Selective031/RazorBoard/Pictures/RazorBoard_30V.jpg

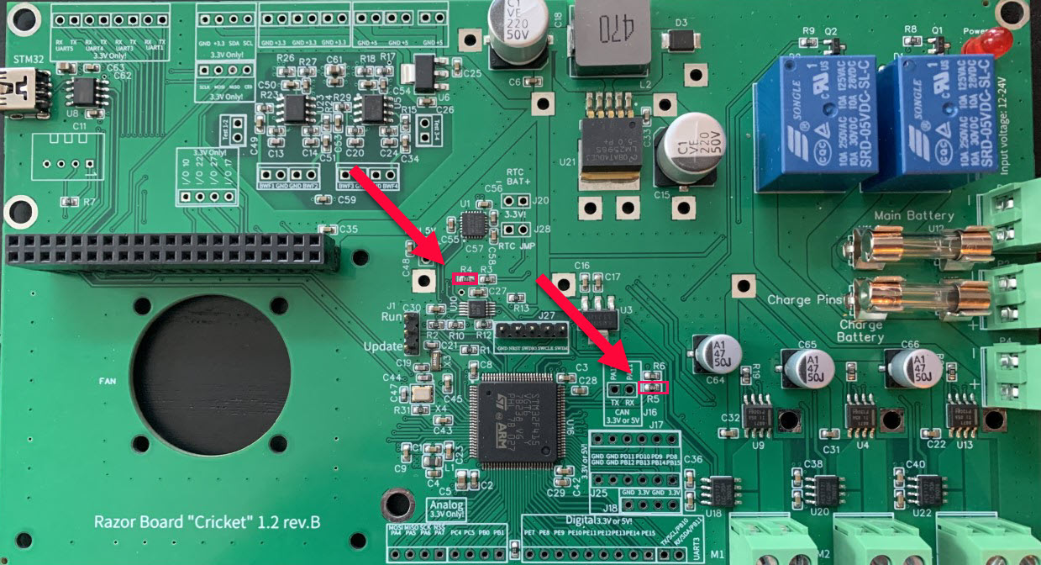
Pictures/RazorBoard_30V.jpg
