Selective031/RazorBoard/mpu_placement.JPG

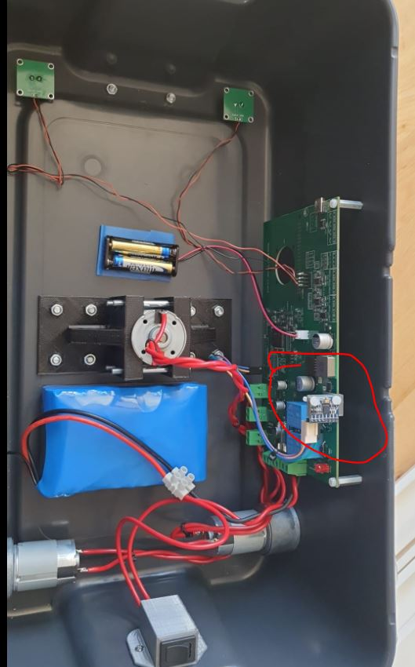
mpu_placement.JPG
