Selective031/RazorBoard/LOWPASS1.png

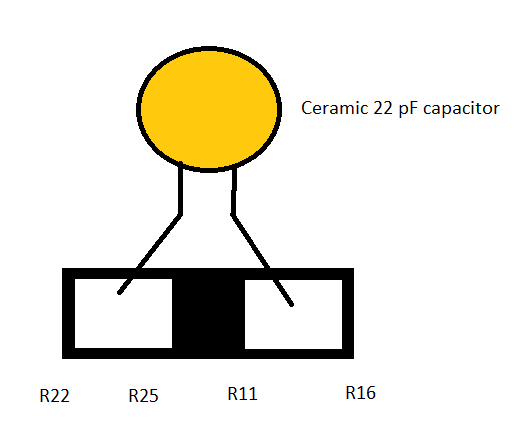
LOWPASS1.png
