Selective031/RazorBoard/Pictures/Node-RED_Nodes.JPG

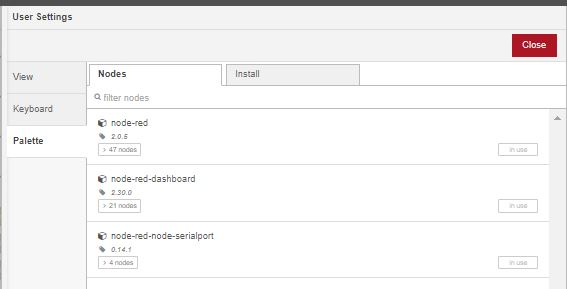
Pictures/Node-RED_Nodes.JPG
