Selective031/RazorBoard/Pictures/Node-RED_SoftwareUpdate.png

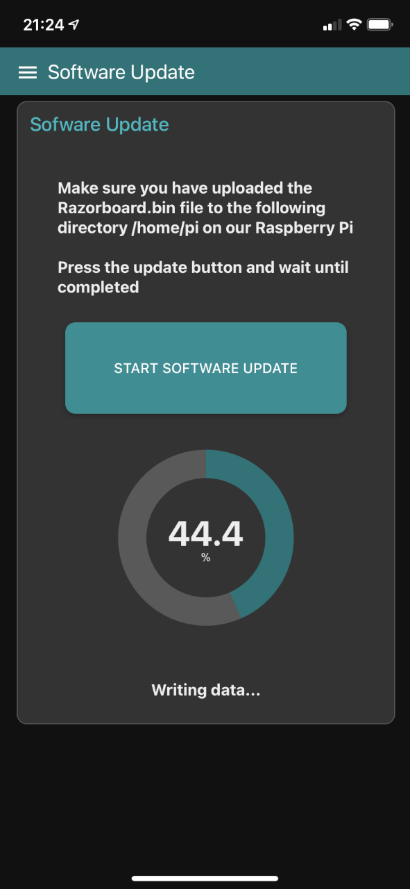
Pictures/Node-RED_SoftwareUpdate.png
