Selective031/RazorBoard/Pictures/Node-RED_Status.PNG

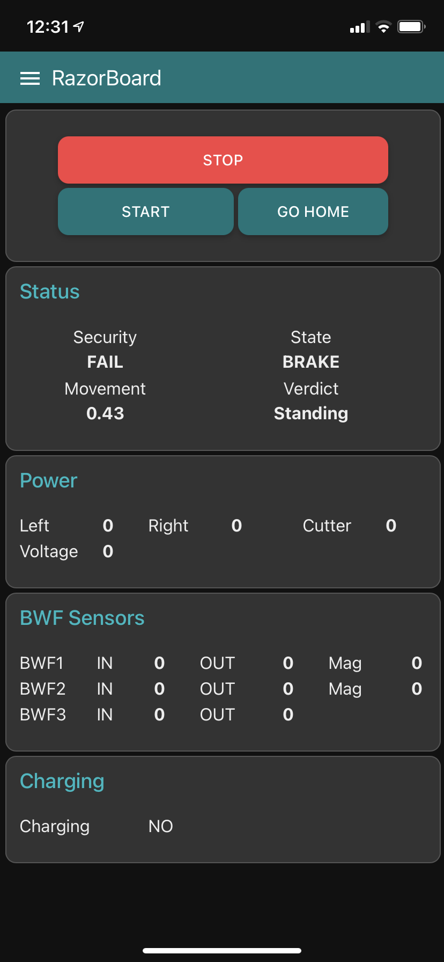
Pictures/Node-RED_Status.PNG
