Selective031/RazorBoard/Pictures/Node-RED_Terminal.JPG

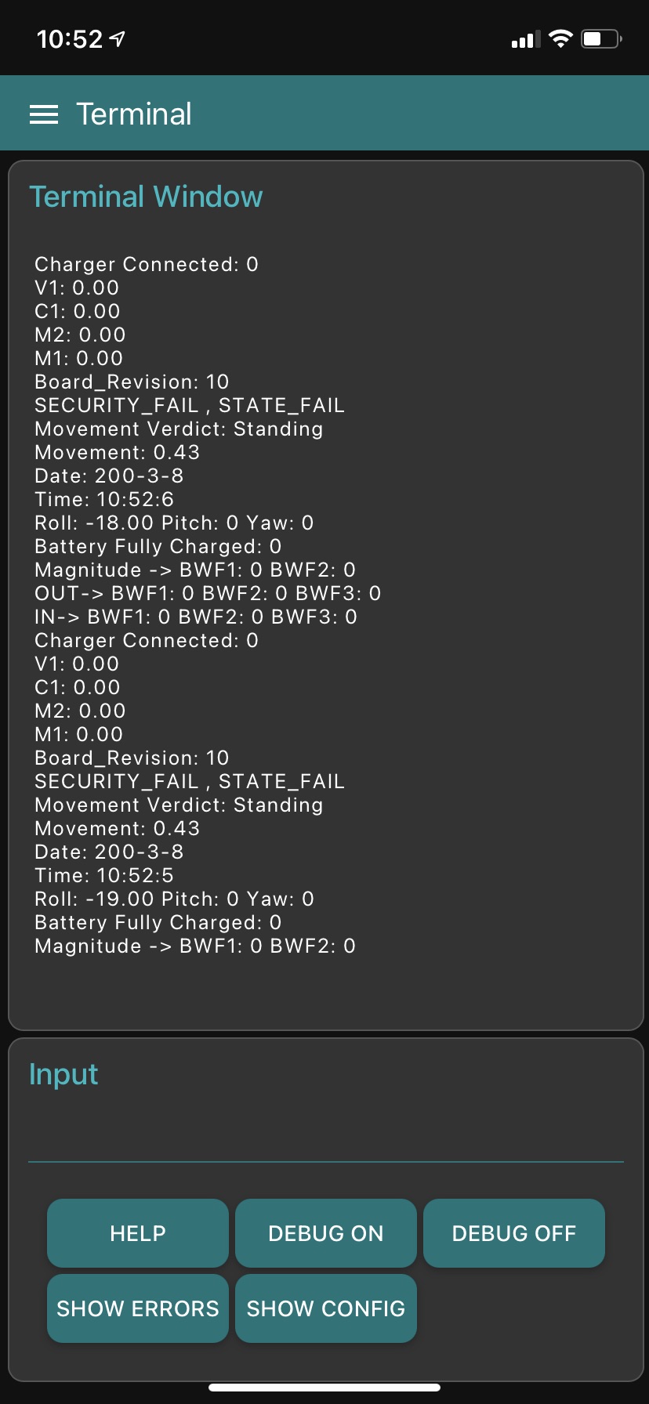
Pictures/Node-RED_Terminal.JPG
