Selective031/RazorBoard/Pictures/Remote Firmware Update.jpg

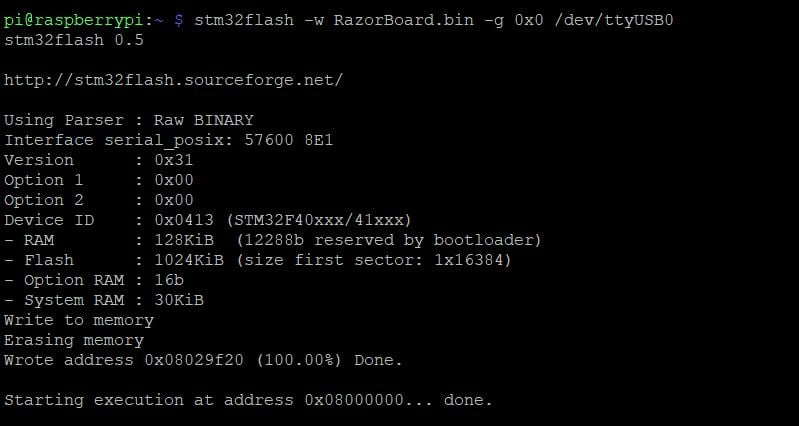
Pictures/Remote Firmware Update.jpg
