Selective031/RazorBoard/rz.png

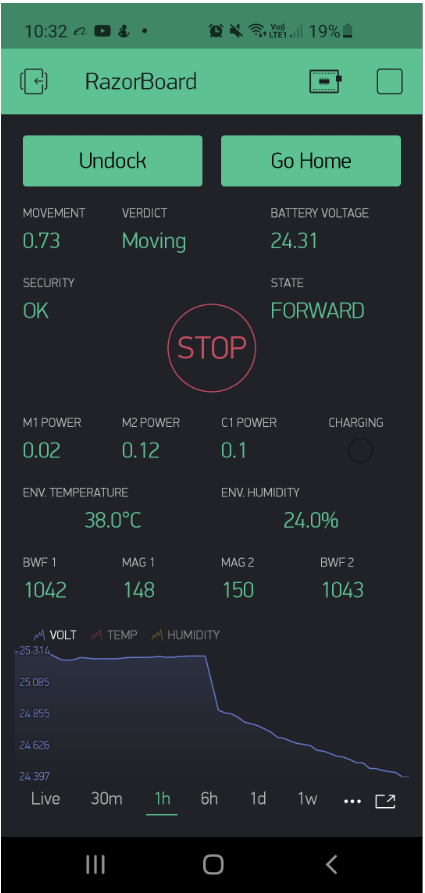
rz.png
