Selective031/RazorBoard/USB.png

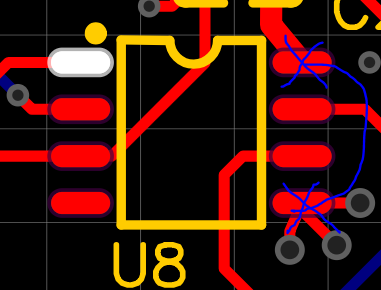
USB.png
