Selective031/RazorBoard/(threads)

Thread 1 (2021-04-14):

Add Bumper Support

Starsurfer78, 2021-04-14:
If i read the README right, they are no Bumpers yet. It would be nice if you can add it 2 Pins for it. Perhaps
Micro Switch or Hall Sensors.

Selective031, 2021-04-15:
No bumber support yet, I wrote some code a while back which I later removed because the motor spike was very good. But of course there should be bumber support.

MagnusPer, 2021-04-30:
Could not a ultrasonic sensor do the jobb!
DYP-A02YY PWM / UART DC5V Ultrasonic Ranging Sensors Ultrasonic Waterproof Distance Sensor Waterproof Probe Ultrasonic module - UART serial por

Starsurfer78, 2021-05-01:
Yes but if the Ultrasonic didn't see the Obstacle then the bumper is a safety device

Thread 3 (2021-04-16):

Stop / Halt button

MagnusPer, 2021-04-16:
A feature to stop / halt the mower by a mechanical switch without breaking the power to the board.

Selective031, 2021-04-16:
This should be a very simple enhancement, there is a "MasterSwitch" in the software, we could just connect a button via an interrupt to switch the "MasterSwitch" to off.

MagnusPer, 2021-04-27:
Another usage for this button is to restart the mower if it has gone out_of_boundary. If you today lift up the mower and walk away the cutter restarts by itself when it sense it is inside the boundary. This is mainly for security reason to not restart when you walk around with the mower!

Starsurfer78, 2021-07-29:
A Start/Stop Button is a nice Idea,
Sometimes it is necessary to send the mower home because it may not be convenient for it to mow.
So a start/stop button **and** a home button would be great.

Thread 4 (2021-04-16):

High grass detection

MagnusPer, 2021-04-16:
The current functionality is the following

`If the current is too high on the cutting disk, it will HARDBREAK and STOP, until reset by the user.`

This is most likely because of high grass and I suggest instead to turn off the cutter motor, drive away and restart the cutter again. If the current is still high after X retries then HARDBREAK and STOP and report failure HIGH GRASS

Selective031, 2021-04-16:
Agreed, the "current to high" limit is more if you hit something and the cutting disk it hitting an hard object, we don´t want to hurt anyone or risking the disk/motor/shaft to break. We could pass the value from the sensor into an array and calculate the average value for about 20-50 values or so, then detect if its hard for the disk to spin and take some action.

Selective031, 2021-05-31:
A new function is being tested.
When the high grass is detected, the mower will do:
MotorStop
MotorBackward
Wait 2 sec (to allow the cutter to speed up again)
Go forward slowly
if high grass is detected again, it will start over
if not, the mower will go forward slowly for 10 sec, then speed up to normal speed again.

Selective031, 2021-06-15:
Released

Closed 2021-06-15.

Thread 5 (2021-04-16):

Support of 30V input voltage

MagnusPer, 2021-04-16:
Many mowers today uses 7-cells Lithium batteries with a charger voltage of 29.3V. To support those battery types I suggest a hardware configuration by a jumper on the next version of PCB to support more than todays max 25.2V.

Selective031, 2021-04-16:
After our discussion I looked into it, and should not be a problem to include in a future revision. It´s only a couple of resistors to replace.

MagnusPer, 2021-04-16:
I created this issue more to inform other persons that having the same issue. However either in this issue or in the Readme section describe the needed changes.

Selective031, 2021-04-16:
This has been added to the README:

Do NOT connect a 7 cell battery! When fully charged it will output 29.4 Volt (7 * 4.2 = 29.4 Volt)
If you really need to provide a 7 cell battery, you need to replace a couple of resistors, they are in the package of SMD 0603. Without replacing them you might risk to blow up a couple of pins on the STM32 MCU.

The resistor that needs to be replaced:
-R3 30K
-R4 7.5K
-R6 30K
-R5 7.5K

With the above resistors, an input voltage of 25.2 would give us 5.0.4 volt, which we can handle.
But if using 30 Volt you will get about 6V which will burn the pins. You need to replace two of them (R3 or R4 and R5 or R6), so you don´t go above 5 Volt.
Use this link for calculating the divider. Also when you replaced them, you need to update the software to calculate the correct voltage.
https://ohmslawcalculator.com/voltage-divider-calculator
Do this at your own risk.

Thread 6 (2021-04-16):

Spinning detection

MagnusPer, 2021-04-16:
If the mower stands still but the motors is running the mower is stuck. The proposal is to use the Gyro to detect the movement where the mower should try by redirect the move direction several times in different directions till it moves again. If several retries doesn't help then HANDBREAK and STOP and report a failure MOWER STUCK

Selective031, 2021-04-16:
Good suggestion!

MagnusPer, 2021-05-03:
Clarification to my comment about using the Gyro, to solve this the accelerometer functionality in the MPU6050 is needed to be used.

Selective031, 2021-05-03:
Yes, that is understood.

Selective031, 2021-05-04:
I solution has been committed to dev branch, just need to verify and test it a bit before moving to main.

Closed 2021-05-05.

Thread 8 (2021-04-16):

Separate configuration file

MagnusPer, 2021-04-16:
Instead of rebuilding the project when change/test some configuration values a separate config file should be super!

Selective031, 2021-04-16:
This is about to be released, all functions are already done. Only thing I need to add are what settings should be presented to the user. Also, if the board doesn´t detect any settings (like powering up for the first time) it will automatically save default config.

Selective031, 2021-04-25:
The first version of this was released in 1.0.1, more to come...

MagnusPer, 2021-04-27:
I have tested the configuration introduced in 1.0.1 version. Well done!
For me OK to set this to done

Selective031, 2021-04-27:
Perfect. closing this.

Closed 2021-04-27.

Thread 9 (2021-04-21):

Turn OFF mower if voltage level is low

MagnusPer, 2021-04-21:
When the mower doesn't find the "home" the battery will be drained. Add a third voltage limit` Voltage_Limit_EMPTY` triggering to turn OFF the mower fully.

The comment in the defines is not fully correct, should be that `Voltage_Limit_LOW // When charging is needed`

```
#define Voltage_Fully_Charged  25000  // When to consider battery fully charged, if using lithium, don't fully charge, the battery will last longer.
#define Voltage_Limit_LOW 22000  // When battery is "empty"
```

Thread 12 (2021-05-03):

MotorBackward function limitations

MagnusPer, 2021-05-03:
The MotorBackward function has limitation for how long it could run in time.,

```
#define MotorMaxSpeed 2950 	// 3359 is max PWM for 25Khz at 84 MHz with APB1 Clock
#define MotorMinSpeed 2000        // Minimum speed to start with
```

in my case I want to to back harder and for longer time, but the function don't allow that due to two reasons.
`MotorBackward(MotorMinSpeed+500, MotorMaxSpeed, 3000);`

1.  if (currentSpeed >= maxSpeed) {  break;  }
2.  if (timeCount >= time_ms) {  break;  }

My expectation is that when maxSpeed has been reached the time left shall be used to be driven till it has elapsed.

```
void MotorBackward(uint16_t minSpeed, uint16_t maxSpeed, uint16_t time_ms) {

	State = BACKWARD;
	uint16_t timeCount = 0;

for (uint16_t currentSpeed = minSpeed; currentSpeed < maxSpeed; currentSpeed++) {

	  currentSpeed += 3;
	  if (currentSpeed >= maxSpeed) {
		  break;
	  }

	  TIM4->CCR1 = currentSpeed;
	  TIM4->CCR2 = 0;

	  TIM4->CCR3 = 0;
	  TIM4->CCR4 = currentSpeed;

	  HAL_Delay(1);
	  timeCount++;

	  CheckSecurity();

	  if (timeCount >= time_ms) {
		  break;
	  }
 }
```

Selective031, 2021-05-03:
Correct, this is one of the small quirks that needs to be fixed. The fix will be something like this, at the beginning of the function before the loop starts, create a timer, if the timer reaches it end during the windup, break. If there is still time left when the windup if done, loop and check security until the timer reaches the end, then break.

Selective031, 2021-05-03:
This is untested, but something like this:
```
void MotorBackward(uint16_t minSpeed, uint16_t maxSpeed, uint16_t time_ms) {

	uint32_t motor_timer;
	State = BACKWARD;
//	uint16_t timeCount = 0;

	motor_timer = HAL_GetTick();

for (uint16_t currentSpeed = minSpeed; currentSpeed < maxSpeed; currentSpeed++) {

	  currentSpeed += 3;
	  if (currentSpeed >= maxSpeed) {
		  break;
	  }

	  TIM4->CCR1 = currentSpeed;
	  TIM4->CCR2 = 0;

	  TIM4->CCR3 = 0;
	  TIM4->CCR4 = currentSpeed;

	  HAL_Delay(1);
//	  timeCount++;

//	  CheckSecurity();

	  if (HAL_GetTick() - motor_timer >= time_ms || CheckSecurity() != SECURITY_OK) {
		  break;
	  }
 }
while (HAL_GetTick() - motor_timer < time_ms) {
	if (CheckSecurity() != SECURITY_OK) break;
}
	MotorStop();
}
```

Selective031, 2021-05-03:
The fix should also be included in MotorLeft and MotorRight as well.

MagnusPer, 2021-05-03:
Yes - you are correct in also update in the other functions (MotorLeft/Right) as well

One other idea to make the function even more configurable is also to include step-up `current_speed +=3` as a argument, but that may be to much, don't really know my self if that is needed or not?

Selective031, 2021-05-03:
The step-up count is mainly because of different motors, RPM and power.. you want it to windup slowly and not too fast, so its a balance, but it could be moved to settings,

Selective031, 2021-05-04:
A fix has been committed to dev branch, which will fix this.

Closed 2021-05-05.

Thread 13 (2021-05-05):

Store of failures in SRAM

MagnusPer, 2021-05-05:
To ease the fault tracing to understanding why the mower stopped/tripped etc. The ~20 latest reported failures should be stored to SRAM. The data to store should include at least the type of failure and when it happened, preferable also the value of the data that triggered the failure

Example
`<date><time><failure type><state><data>`

```
<2021-05-05 19:26> <OUTSIDE> <STOP>
<2021-06-10 20:10> <MOTOR M1 CURRENT> <2.3 AMP> <FORWARD>
```

The list of failures should be readable via a command using the COM port

Selective031, 2021-05-31:
This is nearly complete, Razorboard now has 20 lines with 50 characters (1000 bytes) each of messages stored in SRAM, which is retained during power cycles.
Commands:
"show errors"  - will simply show a list of messages, the newest is at the bottom (scroll style)
"clear errors" - will erase the whole list
"add error" - will add a test error message to the list

Selective031, 2021-06-15:
Released

Closed 2021-06-15.

Thread 18 (2021-05-28):

Limit current consumption settings for the motors to not exceed HW limitation

MagnusPer, 2021-05-28:
The HW itself is protected but there is no way software vise to take actions if the settings is above the tolerance of the hardware. The software configuration parameter should then have a max below the HW tolerance.

Selective031, 2021-05-28:
What should the limit do? and should the limit be applied to the resistor limit or the peak limit of hardware?

MagnusPer, 2021-05-28:
You have correct, I was more in to protect persons not having the knowledge about the hardware limitation. I have instead complemented the settings description with this information

https://github.com/Selective031/RazorBoard/wiki/01.--Settings

Closed 2021-05-28.

Thread 27 (2021-07-01):

Some commands are missing in the help menu

MagnusPer, 2021-07-01:
Check the available commands and update help menu. Example are SHOW ERRORS and CLEAR ERRORS

MagnusPer, 2021-07-05:
Remove ADC level since this not is used anymore

Selective031, 2021-07-05:
The two missing commands are now added in the latest commit.
Lets keep ADC level for now, maybe we can move it to some advanced menu.
One though is to separate the different commands into sub-menus, like motors, bwf, battery etc... to make it even easier to find correct commands.

Closed 2021-07-05.

Thread 34 (2021-08-30):

Disable BLDC motors on upgrade command

MagnusPer, 2021-08-30:
When separate BLDC motor PCB (Raptor) is introduced we need to insure the motors are disabled before entering boot in RazorBoard when a Upgrade command is received.
