Selective031/RazorBoard/RazorBoard/Core/Src/main.c

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
/* Includes ------------------------------------------------------------------*/
#include "main.h"

/* USER CODE BEGIN Includes */

#define ARM_MATH_CM4

#include "stdio.h"
#include "string.h"
#include "math.h"
#include <stdlib.h>
#include <time.h>
#include <arm_math.h>
#include <fir_filter.h>
#include <signature.h>
#include <ctype.h>
#include <help.h>
#include <sram.h>
#include <mpu6050.h>
#include <adc.h>
#include <inttypes.h>
#include <stdbool.h>


/* USER CODE END Includes */

/* USER CODE BEGIN PD */

#define I2C1_SCL_Pin GPIO_PIN_6
#define I2C1_SCL_GPIO_Port GPIOB
#define I2C1_SDA_Pin GPIO_PIN_7
#define I2C1_SDA_GPIO_Port GPIOB

IWDG_HandleTypeDef hiwdg;

#define TRUE 1
#define FALSE 0

#define STOP 0
#define FORWARD 1
#define BACKWARD 2
#define LEFT 3
#define RIGHT 4
#define AVOID_OBSTACLE 5
#define FAIL 6
#define BRAKE 7
#define HARDBRAKE 8

#define NOSIGNAL 0
#define INSIDE 1
#define OUTSIDE 2

#define SECURITY_FAIL 0
#define SECURITY_OK 1
#define SECURITY_NOSIGNAL 2
#define SECURITY_LEFT 3
#define SECURITY_RIGHT 4
#define SECURITY_BUMPER 5
#define SECURITY_IMU_FAIL 6
#define SECURITY_OUTSIDE 7
#define SECURITY_MOVEMENT 8
#define SECURITY_BACKWARD_OUTSIDE 9

#define INITIAL_MAX_THRESHOLD 10000

#define PI_BFR_SIZE 64                // Buffer size for RPi
#define CONSOLE_BFR_SIZE 64            // Buffer size for Serial Console

#define MOTOR_LEFT_FORWARD TIM4->CCR2
#define MOTOR_LEFT_BACKWARD TIM4->CCR1
#define MOTOR_RIGHT_FORWARD TIM4->CCR3
#define MOTOR_RIGHT_BACKWARD TIM4->CCR4

double Tick1 = 0;
double Tick2 = 0;
double error = 0;
double lastError = 0;
double cumError = 0;
double elapsedTime = 0;
double rateError = 0;
double previousTime = 0;

uint8_t perimeterTracking = 0;
uint8_t perimeterTrackingActive = 0;

uint8_t Initial_Start = 0;
uint16_t Start_Threshold = 0;

int bwf1_inside = 0;                // Some stats, how many messages we can detect per second
int bwf2_inside = 0;
int bwf3_inside = 0;
int bwf1_outside = 0;
int bwf2_outside = 0;
int bwf3_outside = 0;

uint32_t Boundary_Timer;            // Keep track of time between signals.

float M1_amp = 0.0f;                // Values for AMP per motor
float M2_amp = 0.0f;                // Values for AMP per motor
float C1_amp = 0.0f;                // Values for AMP per motor
float M1_error = 0.0f;              // Auto calibration value stored here.
float M2_error = 0.0f;              // Auto calibration value stored here.
float C1_error = 0.0f;              // Auto calibration value stored here.
float Voltage = 0;

uint8_t BWF1_Status = 0;
uint8_t BWF2_Status = 0;
uint8_t BWF3_Status = 0;
uint8_t State = STOP;
uint8_t cutterStatus = 0;

uint32_t ADC_timer = 0;
uint32_t IMU_timer = 0;
uint32_t OUTSIDE_timer = 0;

uint8_t Docked = 0;
uint8_t Docked_Locked = 0;
uint8_t MasterSwitch = 1;            // This is the "masterswitch", by default this is turned on.

uint8_t PIBuffer[PI_BFR_SIZE];
uint8_t ConsoleBuffer[CONSOLE_BFR_SIZE];
uint8_t UART1_ready = 0;
uint8_t UART2_ready = 0;
uint8_t Security = 0;

uint8_t Battery_Ready = 0;            // Battery fully charged?

uint8_t M1_idx = 0;
uint8_t M2_idx = 0;
uint8_t C1_idx = 0;
float M1_force[20];                    // Array of power consumption of Motor M1, used for detecting if we bump into something
float M2_force[20];                    // Array of power consumption of Motor M2, used for detecting if we bump into something
float C1_force[20];
float V1_array[60];
uint8_t V1_index = 0;
float M1_F = 0;
float M2_F = 0;
float C1_F = 0;
uint8_t Force_Active = 0;            // When the mower has gained enough movement, Force_Active will turn on.

float32_t BWF1[ADC_SAMPLE_LEN / 2];
float32_t BWF2[ADC_SAMPLE_LEN / 2];
float32_t BWF3[ADC_SAMPLE_LEN / 2];
arm_fir_instance_f32 S;
uint8_t Signature_Record = FALSE;

uint16_t magBWF1, magBWF2, magBWF3;

uint32_t MotorSpeedUpdateFreq_timer = 0;        // Timer for MotorSpeed Update
uint8_t MotorSpeedUpdateFreq = 100;                // Freq to update motor speed, in milliseconds

uint8_t ChargerConnect = 0;                        // Are we connected to the charger?
uint8_t DEBUG_RAZORBOARD = 0;                    // Used by "debug on/debug off"
uint8_t mag_near_bwf = 0;

uint32_t mag_timer = 0;
uint32_t move_timer = 0;
uint32_t highgrass_timer = 0;
uint32_t tracking_timeout_timer = 0;
uint32_t GoHome_timer_IN = 0;
uint32_t GoHome_timer_OUT = 0;
uint32_t Charger_start_Timer = 0;                // start of charging time
uint16_t Charger_elapsed_Timer = 0;                // how long charge time
uint8_t highgrass_slowdown = 0;

uint8_t bumper_count = 0;
uint8_t move_count = 0;
uint8_t board_revision = 12;

sram_settings settings;
sram_error errors;
mpu6050 mpu;


/* USER CODE END PD */

ADC_HandleTypeDef hadc1;
ADC_HandleTypeDef hadc2;
DMA_HandleTypeDef hdma_adc1;
DMA_HandleTypeDef hdma_adc2;

I2C_HandleTypeDef hi2c1;
I2C_HandleTypeDef hi2c2;

IWDG_HandleTypeDef hiwdg;

RNG_HandleTypeDef hrng;

RTC_HandleTypeDef hrtc;

TIM_HandleTypeDef htim2;
TIM_HandleTypeDef htim3;
TIM_HandleTypeDef htim4;
TIM_HandleTypeDef htim5;

UART_HandleTypeDef huart1;
UART_HandleTypeDef huart2;
DMA_HandleTypeDef hdma_usart1_rx;
DMA_HandleTypeDef hdma_usart2_rx;

/* USER CODE BEGIN PV */

I2C_HandleTypeDef *razor_hi2c;

/* USER CODE END PV */

void SystemClock_Config(void);
static void MX_GPIO_Init(void);
static void MX_DMA_Init(void);
static void MX_ADC1_Init(void);
static void MX_IWDG_Init(void);
static void MX_RNG_Init(void);
static void MX_USART1_UART_Init(void);
static void MX_USART2_UART_Init(void);
static void MX_TIM3_Init(void);
static void MX_TIM4_Init(void);
static void MX_RTC_Init(void);
static void MX_TIM2_Init(void);
static void MX_TIM5_Init(void);
static void MX_I2C1_Init(void);
static void MX_ADC2_Init(void);
static void MX_I2C2_Init(void);
/* USER CODE BEGIN PFP */

static void MotorStop(void);
static void MotorBrake(void);
static void MotorHardBrake(void);
static void MotorForward(uint16_t minSpeed, uint16_t maxSpeed);
static void MotorBackward(uint16_t minSpeed, uint16_t maxSpeed, uint32_t time_ms);
static void MotorBackwardImpl(uint16_t minSpeed, uint16_t maxSpeed, uint32_t time_ms, bool forced);
static void MotorLeft(uint16_t minSpeed, uint16_t maxSpeed, uint32_t time_ms);
static void MotorRight(uint16_t minSpeed, uint16_t maxSpeed, uint32_t time_ms);
static void CheckState(void);
static uint8_t CheckSecurity(void);
static void CheckBWF(void);
static void CheckBWF_Rear(void);
static void cutterON(void);
static void cutterOFF(void);
static void cutterHardBreak(void);
static void parseCommand_RPI(void);
static void parseCommand_Console(void);
static void perimeterTracker(void);
static void ChargerConnected(void);
void HAL_UART_RxCpltCallback(UART_HandleTypeDef *huart);
void HAL_UART_TxCpltCallback(UART_HandleTypeDef *huart);
static void delay_us(uint16_t us);
static void ADC_Send(uint8_t channel);
static int ADC_Receive();
static void CollectADC(void);
static void SendInfo(void);
static void CheckMotorCurrent(int RAW);
static void UpdateMotorSpeed();
static void unDock(void);
static uint32_t rnd(uint32_t maxValue);
static void InitFIR(void);
static void FIR_LEFT(void);
static void FIR_RIGHT(void);
static void FIR_REAR(void);
static void WatchdogRefresh(void);
static void WatchdogInit(void);
static void (*SysMemBootJump)(void);
static void BootLoaderInit(unsigned long BootLoaderStatus);
static void setTime(uint8_t hour, uint8_t minute, uint8_t second);
static void setDate(uint8_t year, uint8_t month, uint8_t day, uint8_t weekday);
static void TimeToGoHome(void);
static void CalcMagnitude(uint8_t Sensor);
static void delay(uint32_t time_ms);
static void getIMUOrientation(void);
static void i2c_scanner(void);
static void Serial_DATA(char *msg);
static void I2C_ClearBusyFlagErratum(I2C_HandleTypeDef* handle, uint32_t timeout);
static bool wait_for_gpio_state_timeout(GPIO_TypeDef *port, uint16_t pin, GPIO_PinState state, uint32_t timeout);

/* USER CODE END PFP */

/* USER CODE BEGIN 0 */

bool wait_for_gpio_state_timeout(GPIO_TypeDef *port, uint16_t pin, GPIO_PinState state, uint32_t timeout)
 {
    uint32_t Tickstart = HAL_GetTick();
    bool ret = true;
    /* Wait until flag is set */
    for(;(state != HAL_GPIO_ReadPin(port, pin)) && (true == ret);)
    {
        /* Check for the timeout */
        if (timeout != HAL_MAX_DELAY)
        {
            if ((timeout == 0U) || ((HAL_GetTick() - Tickstart) > timeout))
            {
                ret = false;
            }
            else
            {
            }
        }
        asm("nop");
    }
    return ret;
}

void I2C_ClearBusyFlagErratum(I2C_HandleTypeDef* handle, uint32_t timeout)
{
    GPIO_InitTypeDef GPIO_InitStructure;

    // 1. Clear PE bit.
    CLEAR_BIT(handle->Instance->CR1, I2C_CR1_PE);

    //  2. Configure the SCL and SDA I/Os as General Purpose Output Open-Drain, High level (Write 1 to GPIOx_ODR).
    HAL_I2C_DeInit(handle);

    GPIO_InitStructure.Mode = GPIO_MODE_OUTPUT_OD;
    GPIO_InitStructure.Pull = GPIO_NOPULL;

    GPIO_InitStructure.Pin = I2C1_SCL_Pin;
    HAL_GPIO_Init(GPIOB, &GPIO_InitStructure);

    GPIO_InitStructure.Pin = I2C1_SDA_Pin;
    HAL_GPIO_Init(I2C1_SDA_GPIO_Port, &GPIO_InitStructure);

    // 3. Check SCL and SDA High level in GPIOx_IDR.
    HAL_GPIO_WritePin(I2C1_SDA_GPIO_Port, I2C1_SDA_Pin, GPIO_PIN_SET);
    HAL_GPIO_WritePin(I2C1_SCL_GPIO_Port, I2C1_SCL_Pin, GPIO_PIN_SET);

    wait_for_gpio_state_timeout(I2C1_SCL_GPIO_Port, I2C1_SCL_Pin, GPIO_PIN_SET, timeout);
    wait_for_gpio_state_timeout(I2C1_SDA_GPIO_Port, I2C1_SDA_Pin, GPIO_PIN_SET, timeout);

    // 4. Configure the SDA I/O as General Purpose Output Open-Drain, Low level (Write 0 to GPIOx_ODR).
    HAL_GPIO_WritePin(I2C1_SDA_GPIO_Port, I2C1_SDA_Pin, GPIO_PIN_RESET);

    // 5. Check SDA Low level in GPIOx_IDR.
    wait_for_gpio_state_timeout(I2C1_SDA_GPIO_Port, I2C1_SDA_Pin, GPIO_PIN_RESET, timeout);

    // 6. Configure the SCL I/O as General Purpose Output Open-Drain, Low level (Write 0 to GPIOx_ODR).
    HAL_GPIO_WritePin(I2C1_SCL_GPIO_Port, I2C1_SCL_Pin, GPIO_PIN_RESET);

    // 7. Check SCL Low level in GPIOx_IDR.
    wait_for_gpio_state_timeout(I2C1_SCL_GPIO_Port, I2C1_SCL_Pin, GPIO_PIN_RESET, timeout);

    // 8. Configure the SCL I/O as General Purpose Output Open-Drain, High level (Write 1 to GPIOx_ODR).
    HAL_GPIO_WritePin(I2C1_SCL_GPIO_Port, I2C1_SCL_Pin, GPIO_PIN_SET);

    // 9. Check SCL High level in GPIOx_IDR.
    wait_for_gpio_state_timeout(I2C1_SCL_GPIO_Port, I2C1_SCL_Pin, GPIO_PIN_SET, timeout);

    // 10. Configure the SDA I/O as General Purpose Output Open-Drain , High level (Write 1 to GPIOx_ODR).
    HAL_GPIO_WritePin(I2C1_SDA_GPIO_Port, I2C1_SDA_Pin, GPIO_PIN_SET);

    // 11. Check SDA High level in GPIOx_IDR.
    wait_for_gpio_state_timeout(I2C1_SDA_GPIO_Port, I2C1_SDA_Pin, GPIO_PIN_SET, timeout);

    // 12. Configure the SCL and SDA I/Os as Alternate function Open-Drain.
    GPIO_InitStructure.Mode = GPIO_MODE_AF_OD;
    GPIO_InitStructure.Alternate = GPIO_AF4_I2C1;

    GPIO_InitStructure.Pin = I2C1_SCL_Pin;
    HAL_GPIO_Init(I2C1_SCL_GPIO_Port, &GPIO_InitStructure);

    GPIO_InitStructure.Pin = I2C1_SDA_Pin;
    HAL_GPIO_Init(I2C1_SDA_GPIO_Port, &GPIO_InitStructure);

    // 13. Set SWRST bit in I2Cx_CR1 register.
    SET_BIT(handle->Instance->CR1, I2C_CR1_SWRST);
    asm("nop");

    /* 14. Clear SWRST bit in I2Cx_CR1 register. */
    CLEAR_BIT(handle->Instance->CR1, I2C_CR1_SWRST);
    asm("nop");

    /* 15. Enable the I2C peripheral by setting the PE bit in I2Cx_CR1 register */
    SET_BIT(handle->Instance->CR1, I2C_CR1_PE);
    asm("nop");

    // Call initialization function.
    HAL_I2C_Init(handle);
}


void Serial_DATA(char *msg) {
    HAL_UART_Transmit(&huart1, (uint8_t *) msg, strlen(msg), 100);
}

void i2c_scanner(void) {

	//72 - ADC
	//104 - MPU6050

	if (HAL_I2C_IsDeviceReady(&hi2c1, (uint16_t)(72<<1), 10, 100) == HAL_OK &&
			HAL_I2C_IsDeviceReady(&hi2c1, (uint16_t)(104<<1), 10, 100) == HAL_OK) {
		Serial_Console("Scanner OK PCB 1.2\r\n");
		board_revision = 12;
		razor_hi2c = &hi2c1;

	} else if (HAL_I2C_IsDeviceReady(&hi2c2, (uint16_t)(104<<1), 10, 100) == HAL_OK){
		Serial_Console("Scanner OK PCB 1.0\r\n");
		board_revision = 10;
		razor_hi2c = &hi2c2;
	}
	else {
		board_revision = 12;
		razor_hi2c = &hi2c1;
	}
}

void getIMUOrientation(void) {
    for (uint8_t x = 0; x < 20; x++) {
        MPU6050_Read_Accel();
        MPU6050_Read_Gyro();
        ProcessIMUData(settings);
    }
}

void delay(uint32_t time_ms) {
    uint32_t timer;
    timer = HAL_GetTick();

    while (HAL_GetTick() - timer < time_ms) {
        CheckSecurity();
    }
}

void reInitIMU(void) {
	// If the I2C bus hangs, this will clear the deadlock and re-init the MPU and ADC

	MotorStop();
	cutterOFF();

	add_error_event("reInit IMU");

	I2C_ClearBusyFlagErratum(&hi2c1, 100);

	Init6050();
}

void CalcMagnitude(uint8_t Sensor) {
    float32_t Mag_Out[LENGTH_SAMPLES / 2];
    float32_t sum = 0;
    float32_t magValue;

    if (Sensor == 1) {
        arm_cmplx_mag_f32(BWF1, Mag_Out, LENGTH_SAMPLES / 2);
    } else if (Sensor == 2) {
        arm_cmplx_mag_f32(BWF2, Mag_Out, LENGTH_SAMPLES / 2);
    }

    for (int y = 0; y < LENGTH_SAMPLES / 2; y++) {
        sum += Mag_Out[y];
    }
    arm_sqrt_f32(sum, &magValue);

    if (Sensor == 1) {
        magBWF1 = round(magValue);
    } else if (Sensor == 2) {
        magBWF2 = round(magValue);
    }

    if ((magBWF1 >= settings.magValue || magBWF2 >= settings.magValue) && (MOTOR_LEFT_FORWARD == settings.motorMaxSpeed || MOTOR_RIGHT_FORWARD == settings.motorMaxSpeed) && Docked == 0) {
        if (mag_near_bwf == 0) {
            mag_near_bwf = 1;
            highgrass_slowdown = 0;
            sprintf(emsg, "proximity alert BWF1: %d BWF2: %d", magBWF1, magBWF2);
            add_error_event(emsg);
        }
        mag_timer = HAL_GetTick();
    } else if (magBWF1 <= settings.magMinValue && magBWF2 <= settings.magMinValue && mag_near_bwf == 1 && Docked == 0) {
        if (HAL_GetTick() - mag_timer >= 3000) {
            mag_near_bwf = 0;
            for (uint32_t x = (settings.motorMaxSpeed * settings.proximitySpeed); x < settings.motorMaxSpeed; x++) {
                MOTOR_LEFT_FORWARD = x;
                MOTOR_RIGHT_FORWARD = x;
                HAL_Delay(1);
                if (CheckSecurity() != SECURITY_OK) {
                    add_error_event("Security fail while in proximity loop");
                    break;
                }
            }
        }
        sprintf(emsg, "proximity cleared BWF1: %d BWF2: %d", magBWF1, magBWF2);
        add_error_event(emsg);
    }
}

void TimeToGoHome(void) {
    // Get Time and check if we should go home

    RTC_TimeTypeDef currTime = {0};
    RTC_DateTypeDef currDate = {0};

    HAL_RTC_GetTime(&hrtc, &currTime, RTC_FORMAT_BIN);
    HAL_RTC_GetDate(&hrtc, &currDate, RTC_FORMAT_BIN);

    if (currTime.Hours >= settings.WorkingHourEnd || Voltage <= settings.Battery_Low_Limit) {
        sprintf(emsg, "tracking enabled %d", currTime.Hours);
        add_error_event(emsg);
        perimeterTracking = 1;
    }
}

void setTime(uint8_t hour, uint8_t minute, uint8_t second) {
    RTC_TimeTypeDef sTime = {0};

    sTime.Hours = RTC_ByteToBcd2(hour);
    sTime.Minutes = RTC_ByteToBcd2(minute);
    sTime.Seconds = RTC_ByteToBcd2(second);
    sTime.DayLightSaving = RTC_DAYLIGHTSAVING_NONE;
    sTime.StoreOperation = RTC_STOREOPERATION_SET;
    HAL_RTC_SetTime(&hrtc, &sTime, RTC_FORMAT_BCD);
}

void setDate(uint8_t year, uint8_t month, uint8_t day, uint8_t weekday) {
    RTC_DateTypeDef sDate = {0};

    sDate.WeekDay = RTC_ByteToBcd2(weekday);
    sDate.Month = RTC_ByteToBcd2(month);
    sDate.Date = RTC_ByteToBcd2(day);
    sDate.Year = RTC_ByteToBcd2(year);
    HAL_RTC_SetDate(&hrtc, &sDate, RTC_FORMAT_BCD);
}

void BootLoaderInit(unsigned long BootLoaderStatus)

// Inside the debug menu you can type "upgrade", this will force the STM into the bootloader, so no need to change the jumper.
{
    SysMemBootJump = (void (*)(void)) (*((unsigned long *) 0x1fff0004));
    if (BootLoaderStatus == 1) {
        HAL_DeInit();
        SysTick->CTRL = 0;
        SysTick->LOAD = 0;
        SysTick->VAL = 0;
        __set_PRIMASK(1);
        __set_MSP(0x20001000);
        SysMemBootJump();
        while (1);
    }
}

void WatchdogInit(void) {
    /*
        Watchdog freq: 32.768 kHz
        Prescaler: 16
        Reload: 4095

        Our Watchdog:

        16 * 4095 = 64
        64 / 32 = 2 seconds
        if the watchdog is not fed within 2 seconds, the Razorboard will simply reboot.
    */

    hiwdg.Instance = IWDG;
    hiwdg.Init.Prescaler = IWDG_PRESCALER_16;
    hiwdg.Init.Reload = 4095;
    HAL_IWDG_Init(&hiwdg);
}

void WatchdogRefresh(void) {
    // refresh the watchdog

    HAL_IWDG_Refresh(&hiwdg);
}

void InitFIR(void) {
    // Initiate the FIR functions

    uint32_t blocksize = BLOCK_SIZE;
    arm_fir_init_f32(&S, NUM_TAPS, (float32_t *) &firCoeffs32[0], &firStateF32[0], blocksize);
}

void FIR_LEFT(void) {
    uint32_t i;
    uint32_t blockSize = BLOCK_SIZE;
    uint32_t numBlocks = LENGTH_SAMPLES / BLOCK_SIZE;
    float32_t *inputF32, *outputF32;
    inputF32 = &BWF1[0];
    outputF32 = &Output[0];
    for (i = 0; i < numBlocks; i++) {
        arm_fir_f32(&S, inputF32 + (i * blockSize), outputF32 + (i * blockSize), blockSize);
    }
    for (int x = 0; x < 256; x++) {
        BWF1[x] = (float) outputF32[x];
    }
}

void FIR_RIGHT(void) {
    uint32_t i;
    uint32_t blockSize = BLOCK_SIZE;
    uint32_t numBlocks = LENGTH_SAMPLES / BLOCK_SIZE;
    float32_t *inputF32, *outputF32;
    inputF32 = &BWF2[0];
    outputF32 = &Output[0];
    for (i = 0; i < numBlocks; i++) {
        arm_fir_f32(&S, inputF32 + (i * blockSize), outputF32 + (i * blockSize), blockSize);
    }
    for (int x = 0; x < 256; x++) {
        BWF2[x] = (float) outputF32[x];
    }
}

void FIR_REAR(void) {
    uint32_t i;
    uint32_t blockSize = BLOCK_SIZE;
    uint32_t numBlocks = LENGTH_SAMPLES / BLOCK_SIZE;
    float32_t *inputF32, *outputF32;
    inputF32 = &BWF3[0];
    outputF32 = &Output[0];
    for (i = 0; i < numBlocks; i++) {
        arm_fir_f32(&S, inputF32 + (i * blockSize), outputF32 + (i * blockSize), blockSize);
    }
    for (int x = 0; x < 256; x++) {
        BWF3[x] = (float) outputF32[x];
    }
}

uint32_t rnd(uint32_t maxValue) {
    // Our random number generator

    uint32_t rndnum;
    rndnum = HAL_RNG_GetRandomNumber(&hrng) % maxValue;
    return rndnum + 1;
}

void CheckMotorCurrent(int RAW) {
    // Check if any motor is experiencing a spike in power, then we probably hit something.

    float M1, M2;
    if (M1_idx == 10 || M2_idx == 10 || C1_idx == 10) {
        Force_Active = 1;
    }

    if (Channel == M1_addr) {
        M1_Value = RAW;
        M1 = fabsf(((M1_Value * 0.1875) - 2500) / 100);
        if (Initial_Start == 0) {
            M1_error = M1;
        }
        M1_amp = fabsf(M1 - M1_error);
        M1_force[M1_idx] = M1_amp;
        M1_idx++;
        if (M1_idx == 20) {
            M1_idx = 0;
        }
        float ForceM1 = 0;
        for (int x = 0; x < 20; x++) {
            ForceM1 += M1_force[x];
        }
        M1_F = ForceM1 / 20;
        if (M1_F < settings.Motor_Min_Limit) {
            M1_F = settings.Motor_Min_Limit;
        }
        if ((M1_amp >= settings.Motor_Max_Limit || M1_amp >= M1_F * settings.Motor_Limit) && State == (FORWARD || RIGHT) && Force_Active == 1 && M1_amp < 10.0) {
            sprintf(emsg, "M1 current: %.2f", M1_amp);
            add_error_event(emsg);
            sprintf(msg, "Motor Current Limit reached for M1: %.2f", M1_amp);
            Serial_Console(msg);

            if (HAL_GPIO_ReadPin(GPIOA, GPIO_PIN_8) == GPIO_PIN_SET) {
                return;
            }
            MotorBrake();
            delay(500);
            MotorBackward(settings.motorMinSpeed, settings.motorMaxSpeed, 1500);
            delay(500);
            MotorRight(settings.motorMinSpeed, settings.motorMaxSpeed, 1000);
            Force_Active = 0;
            bumper_count++;
            M1_amp = 0;
        }
    } else if (Channel == M2_addr) {
        M2_Value = RAW;
        M2 = fabsf(((M2_Value * 0.1875) - 2500) / 100);
        if (Initial_Start == 0) {
            M2_error = M2;
        }
        M2_amp = fabsf(M2 - M2_error);
        M2_force[M2_idx] = M2_amp;
        M2_idx++;
        if (M2_idx == 20) {
            M2_idx = 0;
        }
        float ForceM2 = 0;
        for (int x = 0; x < 20; x++) {
            ForceM2 += M2_force[x];
        }
        M2_F = ForceM2 / 20;
        if (M2_F < settings.Motor_Min_Limit) {
            M2_F = settings.Motor_Min_Limit;
        }
        if ((M2_amp >= settings.Motor_Max_Limit || M2_amp >= M2_F * settings.Motor_Limit) && State == (FORWARD || LEFT) && Force_Active == 1 && M2_amp < 10.0) {
            sprintf(emsg, "M2 current: %.2f", M2_amp);
            add_error_event(emsg);
            sprintf(msg, "Motor Current Limit reached for M2: %.2f", M2_amp);
            Serial_Console(msg);

            if (HAL_GPIO_ReadPin(GPIOA, GPIO_PIN_8) == GPIO_PIN_SET) {
                return;
            }
            MotorBrake();
            delay(500);
            MotorBackward(settings.motorMinSpeed, settings.motorMaxSpeed, 1500);
            delay(500);
            MotorLeft(settings.motorMinSpeed, settings.motorMaxSpeed, 1000);
            Force_Active = 0;
            bumper_count++;
            M2_amp = 0;
        }
    }
}

void SendInfo() {
    if (DEBUG_RAZORBOARD == 0) {
        bwf1_inside = 0;
        bwf1_outside = 0;
        bwf2_inside = 0;
        bwf2_outside = 0;
        bwf3_inside = 0;
        bwf3_outside = 0;
        return;
    }

    // Send info to the Console & Raspberry PI - Update frequency is ~1 Hz
    RTC_TimeTypeDef currTime = {0};
    RTC_DateTypeDef currDate = {0};

    HAL_RTC_GetTime(&hrtc, &currTime, RTC_FORMAT_BIN);
    HAL_RTC_GetDate(&hrtc, &currDate, RTC_FORMAT_BIN);

    sprintf(msg, "M1: %.2f\r\n", M1_amp);
    Serial_DATA(msg);
    sprintf(msg, "M2: %.2f\r\n", M2_amp);
    Serial_DATA(msg);
    sprintf(msg, "C1: %.2f\r\n", C1_amp);
    Serial_DATA(msg);
    sprintf(msg, "V1: %.2f\r\n", Voltage);
    Serial_DATA(msg);
    sprintf(msg, "Charger Connected: %d\r\n", ChargerConnect);
    Serial_DATA(msg);
    if (ChargerConnect == 1) {
        sprintf(msg, "Charger elapsed time (min): %d\r\n", Charger_elapsed_Timer);
        Serial_DATA(msg);
    }
    sprintf(msg, "IN-> BWF1: %d BWF2: %d BWF3: %d\r\nOUT-> BWF1: %d BWF2: %d BWF3: %d\r\n", bwf1_inside, bwf2_inside,
            bwf3_inside, bwf1_outside, bwf2_outside, bwf3_outside);
    Serial_DATA(msg);
    sprintf(msg, "Magnitude -> BWF1: %d BWF2: %d\r\n", magBWF1, magBWF2);
    Serial_DATA(msg);
    sprintf(msg, "Battery Fully Charged: %d\r\n", Battery_Ready);
    Serial_DATA(msg);
    sprintf(msg, "Roll: %.2f Pitch: %2.f Yaw: %2.f\r\n", mpu.roll, mpu.pitch, mpu.yaw);
    Serial_DATA(msg);
    sprintf(msg, "Time: %d:%d:%d\r\n", currTime.Hours, currTime.Minutes, currTime.Seconds);
    Serial_DATA(msg);
    sprintf(msg, "Date: 20%d-%d-%d\r\n", currDate.Year, currDate.Month, currDate.Date);
    Serial_DATA(msg);
    sprintf(msg, "Movement: %.2f\r\n", mpu.movement);
    Serial_DATA(msg);
    sprintf(msg, "Perimeter tracking: %d\r\n", perimeterTracking);
    Serial_DATA(msg);
    if (mpu.movement < settings.movement) {
        sprintf(msg, "Movement Verdict: Standing\r\n");
    } else {
        sprintf(msg, "Movement Verdict: Moving\r\n");
    }
    Serial_DATA(msg);
    if (Security == 0) {
        Serial_DATA("Security FAIL\r\n");
    }
    if (Security == 1) {
        Serial_DATA("Security OK\r\n");
    }
    if (Security == 2) {
        Serial_DATA("Security OUTSIDE\r\n");
    }
    if (Security == 3) {
        Serial_DATA("Security LEFT\r\n");
    }
    if (Security == 4) {
        Serial_DATA("Security RIGHT\r\n");
    }
    if (Security == 5) {
        Serial_DATA("Security BUMPER\r\n");
    }
    if (Security == 6) {
        Serial_DATA("Security IMU_FAIL\r\n");
    }
    if (Security == 7) {
        Serial_DATA("Security OUSIDE\r\n");
    }
    if (Security == 8) {
        Serial_DATA("Security MOVEMENT\r\n");
    }
    if (Security == 9) {
        Serial_DATA("Security BACKWARD_OUTSIDE\r\n");
    }
    if (State == 0) {
        Serial_DATA("State STOP\r\n");
    }
    if (State == 1) {
        Serial_DATA("State FORWARD\r\n");
    }
    if (State == 2) {
        Serial_DATA("State BACKWARD\r\n");
    }
    if (State == 3) {
        Serial_DATA("State LEFT\r\n");
    }
    if (State == 4) {
        Serial_DATA("State RIGHT\r\n");
    }
    if (State == 5) {
        Serial_DATA("State AVOID_OBSTACLE\r\n");
    }
    if (State == 6) {
        Serial_DATA("State FAIL\r\n");
    }
    if (State == 7) {
        Serial_DATA("State BRAKE\r\n");
    }
    if (State == 8) {
        Serial_DATA("State HARDBRAKE\r\n");
    }
    sprintf(msg, "Docking Station Locked: %u\r\n", Docked_Locked);
    Serial_Console(msg);
    sprintf(msg, "Board_Revision: %d\r\n", board_revision);
    Serial_DATA(msg);

/*
    char Data[128];

    sprintf(Data, "Battery Voltage,%.2f\r\n"
                  "M1 Current,%.2f\r\n"
                  "M2 Current,%.2f\r\n"
                  "C1 Current,%.2f\r\n"
                  "Security,%d\r\n"
                  "Mower State,%d\r\n", Voltage, M1_amp, M2_amp, C1_amp, Security, State);

*/
    bwf1_inside = 0;
    bwf1_outside = 0;
    bwf2_inside = 0;
    bwf2_outside = 0;
    bwf3_inside = 0;
    bwf3_outside = 0;

//    HAL_UART_Transmit(&huart2, (uint8_t *) &Data, strlen(Data), 100);

}

void CollectADC() {
    // Collect IC2 data from the external ADC, in a non-blocking way.

    if (Channel == M1_addr && Channel_Status == 0) {
        ADC_Send(Channel);
        Channel_Status = 1;
        ADC_timer = HAL_GetTick();
    } else if (Channel == M2_addr && Channel_Status == 0) {
        ADC_Send(Channel);
        Channel_Status = 1;
        ADC_timer = HAL_GetTick();
    } else if (Channel == C1_addr && Channel_Status == 0) {
        ADC_Send(Channel);
        Channel_Status = 1;
        ADC_timer = HAL_GetTick();
    } else if (Channel == V1_addr && Channel_Status == 0) {
        ADC_Send(Channel);
        Channel_Status = 1;
        ADC_timer = HAL_GetTick();
    }

    if ((HAL_GetTick() - ADC_timer) >= 20 && Channel_Status == 1) {
        int RAW = 0;
        RAW = ADC_Receive();

        CheckMotorCurrent(RAW);

        if (Channel == C1_addr && Docked == 0) {
            C1_Value = RAW;
            float C1;
            C1 = fabsf(((C1_Value * 0.1875) - 2500) / 100);
            if (Initial_Start == 0) {
                C1_error = C1;
            }
            C1_amp = fabsf(C1 - C1_error);

            if (C1_amp >= settings.highgrass_Limit && mag_near_bwf == 0 && C1_amp < 10.0) {
                C1_amp = 0.0;
                highgrass_slowdown = 1;
                MotorStop();
                MotorBackward(settings.motorMinSpeed, settings.motorMaxSpeed, 1500);
                delay(2500);
                MotorForward(settings.motorMinSpeed, settings.motorMaxSpeed * 0.78);
                highgrass_timer = HAL_GetTick();
            } else {
                if (HAL_GetTick() - highgrass_timer >= 5000 && highgrass_slowdown == 1) {
                    highgrass_slowdown = 0;
                    for (uint32_t x = (settings.motorMaxSpeed * 0.78); x < settings.motorMaxSpeed; x++) {
                        MOTOR_LEFT_FORWARD = x;
                        MOTOR_RIGHT_FORWARD = x;
                        delay(1);
                        if (CheckSecurity() != SECURITY_OK) {
                            add_error_event("Security fail while in high grass loop");
                            break;
                        }
                    }
                }
            }
            if (C1_amp >= settings.Cutter_Limit) {
                sprintf(emsg, "C1 current: %.2f", C1_amp);
                add_error_event(emsg);
                MasterSwitch = 0;
                return;
            }
        } else if (Channel == V1_addr) {
            V1_Value = RAW;
            V1_array[V1_index] = (V1_Value * 0.1875) * settings.voltageMultiply / 1000;
            V1_index++;
            if (V1_index >= 60) {
                V1_index = 0;
            }
            float volt_sum = 0.0;
            for (uint8_t x = 0; x < 60; x++) {
                volt_sum += V1_array[x];
            }
            Voltage = volt_sum / 60;
        }

        if (Channel == M1_addr) {
            Channel = M2_addr;
        } else if (Channel == M2_addr) {
            Channel = C1_addr;
        } else if (Channel == C1_addr) {
            Channel = V1_addr;
        } else if (Channel == V1_addr) {
            Channel = M1_addr;
        }
        Channel_Status = 0;
    }
}

void delay_us(uint16_t us) {
    __HAL_TIM_SET_COUNTER(&htim5, 0);  // set the counter value a 0
    while (__HAL_TIM_GET_COUNTER(&htim5) < us);  // wait for the counter to reach the us input in the parameter
}

void unDock(void) {
    // Simple undock sequence,  check if Battery is ready (fully charged) and if we are within working hours.

    RTC_TimeTypeDef currTime = {0};
    RTC_DateTypeDef currDate = {0};

    HAL_RTC_GetTime(&hrtc, &currTime, RTC_FORMAT_BIN);
    HAL_RTC_GetDate(&hrtc, &currDate, RTC_FORMAT_BIN);

    if (currTime.Hours >= settings.WorkingHourStart && currTime.Hours < settings.WorkingHourEnd && Battery_Ready == 1 && Docked == 1 && Docked_Locked == 0) {
        add_error_event("Switch Main Battery");
        Serial_Console("Switching to Main Battery\r\n");
        HAL_GPIO_WritePin(GPIOD, GPIO_PIN_0, GPIO_PIN_RESET);
        HAL_Delay(5000);

        MasterSwitch = 1;

        mpu.roll = 0;
        mpu.pitch = 0;
        Docked = 0;

        MotorBackwardImpl(settings.motorMinSpeed, settings.motorMaxSpeed, settings.undock_backing_seconds * 1000, true);
        MotorLeft(settings.motorMinSpeed, settings.motorMaxSpeed, 800);            // This needs to be changed if your docking is on the right side

        Initial_Start = 0;
        Start_Threshold = 0;
        Battery_Ready = 0;
        lastError = 0;
        perimeterTracking = 0;
        perimeterTrackingActive = 0;
        write_all_settings(settings);
    }
}

void ChargerConnected(void) {

	// Is the charger connected?

    if (ChargerConnect == 0) {                    // We are not charging, reset charger start timer
        Charger_start_Timer = HAL_GetTick();
        Charger_elapsed_Timer = 0;
    }

    if (ChargerConnect == 1) {                    // We are charging, calculate duration in minutes
        Charger_elapsed_Timer = (HAL_GetTick() - Charger_start_Timer) / 60000;
    }
    if (ChargerConnect == 1 || Docked == 1) {
        if (Voltage >= settings.Battery_High_Limit && Battery_Ready == 0 && Charger_elapsed_Timer >= settings.BatteryChargeTime) {
            Battery_Ready = 1;
            HAL_GPIO_WritePin(GPIOC, GPIO_PIN_10, GPIO_PIN_RESET);
            add_error_event("Charger disconnect");
            Serial_Console("Charger disconnected.\r\n");
            ChargerConnect = 0;
            HAL_Delay(5000);
            unDock();
        }
        return;
    }

    if (HAL_GPIO_ReadPin(GPIOA, GPIO_PIN_8) == GPIO_PIN_SET) {            // Read Volt sense pin
        HAL_Delay(settings.HoldChargeDetection);                          // Wait for a while so a proper connection is made
        Force_Active = 0;
        MotorBrake();
        cutterHardBreak();
        add_error_event("Charger connect");
        Serial_Console("Charger Connected\r\n");
        HAL_Delay(5000);
        HAL_GPIO_WritePin(GPIOD, GPIO_PIN_0, GPIO_PIN_SET);               // Main Power switch
        Serial_Console("Changing Main Power\r\n");
        ChargerConnect = 1;
        Docked = 1;
        HAL_Delay(2000);
        HAL_GPIO_WritePin(GPIOC, GPIO_PIN_10, GPIO_PIN_SET);              // Charger Switch
        add_error_event("Charging active");
        Serial_Console("Charging activated\r\n");

        return;
    }
}

void perimeterTracker(void) {
    CheckSecurity();

    mag_near_bwf = 0;
    highgrass_slowdown = 0;

    elapsedTime = HAL_GetTick() - previousTime;

    if (BWF2_Status == OUTSIDE) {
        Tick1 -= elapsedTime;
        Tick2 = 0;
        GoHome_timer_IN = HAL_GetTick();

        if (HAL_GetTick() - GoHome_timer_OUT >= 10000) {        // 10 seconds
            perimeterTrackingActive = 0;
            perimeterTracking = 0;
            MasterSwitch = 0;
            add_error_event("Stuck perimeterTracking BWF2 OUT - HALT");
            return;
        }
    }

    if (BWF2_Status == INSIDE) {
        Tick2 -= (elapsedTime * 4);
        Tick1 = 0;
        GoHome_timer_OUT = HAL_GetTick();

        if (HAL_GetTick() - GoHome_timer_IN >= 10000) {            // 10 seconds
            perimeterTrackingActive = 0;
            perimeterTracking = 0;
            MasterSwitch = 0;
            add_error_event("Stuck perimeterTracking BWF2 IN - HALT");
            return;
        }
    }

    error = settings.perimeterTrackerSpeed - (Tick1 + Tick2);                // determine error
    cumError += error * elapsedTime;               // compute integral
    rateError = (error - lastError) / elapsedTime;   // compute derivative

    double out = settings.kp * error + settings.ki * cumError + settings.kd * rateError;                //PID output

    lastError = error;                             //remember current error
    previousTime = HAL_GetTick();                  //remember current time

    int speedA = (settings.perimeterTrackerSpeed + round(out));
    int speedB = (settings.perimeterTrackerSpeed - round(out));

    if (speedA > settings.perimeterTrackerSpeed) {
        speedA = settings.perimeterTrackerSpeed;
    }                // limit upper and lower speed
    if (speedB > settings.perimeterTrackerSpeed)
        speedB = settings.perimeterTrackerSpeed;

    if (speedA < 1000)
        speedA = 1000;
    if (speedB < 1000)
        speedB = 1000;

    if (BWF2_Status == OUTSIDE) {
        if (BWF1_Status == OUTSIDE) {
            MOTOR_LEFT_BACKWARD = settings.perimeterTrackerSpeed * 0.90;            // if both boundary sensors are OUTSIDE, reverse M1 motor, this logic needs to be changed if docking is to the right
            MOTOR_LEFT_FORWARD = 0;
            HAL_Delay(200);
        } else if (BWF1_Status == INSIDE) {
            MOTOR_LEFT_BACKWARD = 0;
            MOTOR_LEFT_FORWARD = speedB;
        }

        MOTOR_RIGHT_FORWARD = speedA;
        MOTOR_RIGHT_BACKWARD = 0;
    }

    if (BWF2_Status == INSIDE) {
        MOTOR_LEFT_BACKWARD = 0;
        MOTOR_LEFT_FORWARD = speedA;

        MOTOR_RIGHT_FORWARD = speedB;
        MOTOR_RIGHT_BACKWARD = 0;
    }
}

void parseCommand_Console(void) {
    // Parse commands from the Console

    char Command[64] = {"\0"};

    for (uint8_t x = 0; x < sizeof(ConsoleBuffer); x++) {
        if (ConsoleBuffer[x] == 13) {
            if (ConsoleBuffer[0] == 13) {
                memcpy(Command, "DISABLE", 7);
            } else {
                memcpy(Command, ConsoleBuffer, x);
            }
            sprintf(msg, "%s\r\n", Command);
            Serial_Console(msg);
            for (uint8_t i = 0; i < CONSOLE_BFR_SIZE; i++) {
                Command[i] = toupper(Command[i]);
            }

            if (strcmp(Command, "HELLO") == 0) {
                Serial_Console("Hello fellow user! Welcome to RazorBoard!\r\n");
            }
            if (strcmp(Command, "VERSION") == 0) {
                sprintf(msg, "%s\r\n", VERSION);
                Serial_Console(msg);
            }
            if (strcmp(Command, "DEBUG ON") == 0) {
                DEBUG_RAZORBOARD = 1;
                Serial_Console("DEBUG is now ON\r\n");
            }
            if (strcmp(Command, "DEBUG OFF") == 0) {
                DEBUG_RAZORBOARD = 0;
                Serial_Console("DEBUG is now OFF\r\n");
            }
            if (strcmp(Command, "VOLTAGE") == 0) {
                sprintf(msg, "%.2f\r\n", Voltage);
                Serial_Console(msg);
            }
            if (strcmp(Command, "UPGRADE") == 0) {
                Serial_Console("Entering Bootloader...\r\n");
                HAL_Delay(500);
                BootLoaderInit(1);
            }
            if (strcmp(Command, "SHOW SIG") == 0) {
                Serial_Console("Signature will be printed in 8 seconds, please start your plotter before.\r\n");
                HAL_Delay(8000);
                for (int x = 0; x < SIGNATURE_LEN; x++) {
                    sprintf(msg, "%f\r\n", validSignature[x]);
                    Serial_Console(msg);
                }
            }
            if (strcmp(Command, "EXPORT SIG") == 0) {
                Serial_Console("Signature exported as an array\r\n");
                Serial_Console("{ ");
                for (int x = 0; x < SIGNATURE_LEN; x++) {
                    sprintf(msg, "%f,", validSignature[x]);
                    Serial_Console(msg);
                }
                Serial_Console(" };\r\n");
            }
            if (strcmp(Command, "RECORD SIG") == 0) {
                Signature_Record = TRUE;
                Serial_Console("Done!\r\n");
            }
            if (strcmp(Command, "TEST LEFT MOTOR") == 0) {
                MOTOR_LEFT_BACKWARD = 0;
                MOTOR_LEFT_FORWARD = 2000;
                HAL_Delay(3000);
                MotorStop();
                Serial_Console("Done.\r\n");
            }
            if (strcmp(Command, "TEST RIGHT MOTOR") == 0) {
                MOTOR_RIGHT_FORWARD = 2000;
                MOTOR_RIGHT_BACKWARD = 0;
                HAL_Delay(3000);
                MotorStop();
                Serial_Console("Done.\r\n");
            }
            if (strcmp(Command, "REBOOT") == 0) {
                Serial_Console("Rebooting...\r\n");
                HAL_Delay(500);
                NVIC_SystemReset();
            }
            if (strcmp(Command, "LOCK DOCKING") == 0) {
                Serial_Console("Docking LOCKED.\r\n");
                Docked_Locked = 1;
            }
            if (strcmp(Command, "UNLOCK DOCKING") == 0) {
                Serial_Console("Docking UNLOCKED.\r\n");
                Docked_Locked = 0;
            }
            if (strcmp(Command, "LOAD CONFIG") == 0) {
                settings = read_all_settings();
                Serial_Console("Config loaded.\r\n");
            }
            if (strcmp(Command, "SHOW CONFIG") == 0) {
                show_config(settings);
            }
            if (strcmp(Command, "SHOW ERRORS") == 0) {
                show_error();
            }
            if (strcmp(Command, "ADD ERROR") == 0) {
                add_error_event("This is a test error!");
            }

            if (strcmp(Command, "CLEAR ERRORS") == 0) {
                clear_errors();
            }

            if (strcmp(Command, "SAVE CONFIG") == 0) {
                write_all_settings(settings);
                settings = read_all_settings();
                Serial_Console("Settings saved.\r\n");
            }
            if (strcmp(Command, "SAVE DEFAULT CONFIG") == 0) {
                save_default_settings(board_revision);
                settings = read_all_settings();
                Serial_Console("Default settings saved.\r\n");
            }
            if (strcmp(Command, "SHOW CURRENT") == 0) {
                sprintf(msg, "M1: %.2f\r\nM2: %.2f\r\nC1: %.2f\r\n", M1_amp, M2_amp, C1_amp);
                Serial_Console(msg);
            }
            if (strcmp(Command, "STOP MOTORS") == 0) {
                MotorStop();
            }
            if (strcmp(Command, "RUN MOTORS FORWARD") == 0) {
                State = FORWARD;
                MOTOR_LEFT_BACKWARD = 0;
                MOTOR_LEFT_FORWARD = settings.motorMinSpeed;
                MOTOR_RIGHT_FORWARD = settings.motorMinSpeed;
                MOTOR_RIGHT_BACKWARD = 0;
            }
            if (strcmp(Command, "RUN MOTORS REVERSE") == 0) {
                State = BACKWARD;
                MOTOR_LEFT_BACKWARD = settings.motorMinSpeed;
                MOTOR_LEFT_FORWARD = 0;
                MOTOR_RIGHT_FORWARD = 0;
                MOTOR_RIGHT_BACKWARD = settings.motorMinSpeed;
            }
            if (strncmp(Command, "SET PITCH COMP", 14) == 0) {
                float pitch;
                char cmd1[3], cmd2[5], cmd3[4];
                sscanf(Command, "%s %s %s %f", cmd1, cmd2, cmd3, &pitch);
                settings.pitch_comp = pitch;
            }
            if (strncmp(Command, "SET ROLL COMP", 13) == 0) {
                float roll;
                char cmd1[3], cmd2[4], cmd3[4];
                sscanf(Command, "%s %s %s %f", cmd1, cmd2, cmd3, &roll);
                settings.roll_comp = roll;
            }
            if (strncmp(Command, "SET STEERING CORRECTION", 23) == 0) {
                uint16_t correction;
                char cmd1[3], cmd2[8], cmd3[10];
                sscanf(Command, "%s %s %s %hd", cmd1, cmd2, cmd3, &correction);
                settings.steering_correction = correction;
            }
            if (strncmp(Command, "SET PROXIMITY SPEED", 19) == 0) {
                float speed;
                char cmd1[3], cmd2[9], cmd3[5];
                sscanf(Command, "%s %s %s %f", cmd1, cmd2, cmd3, &speed);
                settings.proximitySpeed = speed;
            }
            if (strncmp(Command, "SET VOLTAGE MULTIPLY", 20) == 0) {
                float multiply;
                char cmd1[3], cmd2[7], cmd3[8];
                sscanf(Command, "%s %s %s %f", cmd1, cmd2, cmd3, &multiply);
                settings.voltageMultiply = multiply;
            }
            if (strncmp(Command, "SET MOTOR MAX LIMIT", 19) == 0) {
                float limit;
                char cmd1[3], cmd2[5], cmd3[3], cmd4[5];
                sscanf(Command, "%s %s %s %s %f", cmd1, cmd2, cmd3, cmd4, &limit);
                settings.Motor_Max_Limit = limit;
            }
            if (strncmp(Command, "SET MOTOR MIN LIMIT", 19) == 0) {
                float limit;
                char cmd1[3], cmd2[5], cmd3[3], cmd4[5];
                sscanf(Command, "%s %s %s %s %f", cmd1, cmd2, cmd3, cmd4, &limit);
                settings.Motor_Min_Limit = limit;
            }
            if (strncmp(Command, "SET MOTOR MAX SPEED", 19) == 0) {
                int speed;
                char cmd1[3], cmd2[5], cmd3[3], cmd4[5];
                sscanf(Command, "%s %s %s %s %d", cmd1, cmd2, cmd3, cmd4, &speed);
                settings.motorMaxSpeed = speed;
            }
            if (strncmp(Command, "SET MOTOR MIN SPEED", 19) == 0) {
                int speed;
                char cmd1[3], cmd2[5], cmd3[3], cmd4[5];
                sscanf(Command, "%s %s %s %s %d", cmd1, cmd2, cmd3, cmd4, &speed);
                settings.motorMinSpeed = speed;
            }
			if (strncmp(Command, "SET MOTOR TURN STATIC", 21) == 0) {
				uint16_t time;
				char cmd1[3], cmd2[5], cmd3[4], cmd4[6];
				sscanf(Command, "%s %s %s %s %hd", cmd1, cmd2, cmd3, cmd4, &time);
				settings.motorTurnStatic_time =  time;
			}
			if (strncmp(Command, "SET MOTOR TURN RANDOM", 21) == 0) {
				uint16_t time;
				char cmd1[3], cmd2[5], cmd3[4], cmd4[6];
				sscanf(Command, "%s %s %s %s %hd", cmd1, cmd2, cmd3, cmd4, &time);
				settings.motorTurnRandom_time =  time;
			}
			if (strncmp(Command, "SET MOTOR BACKWARD", 18) == 0) {
				uint16_t time;
				char cmd1[3], cmd2[5], cmd3[8];
				sscanf(Command, "%s %s %s %hd", cmd1, cmd2, cmd3, &time);
				settings.motorBackward_time =  time;
			}
            if (strncmp(Command, "SET ROLL TILT COMP", 18) == 0) {
                int comp;
                char cmd1[3], cmd2[4], cmd3[4], cmd4[4];
                sscanf(Command, "%s %s %s %s %d", cmd1, cmd2, cmd3, cmd4, &comp);
                settings.roll_tilt_comp = comp;
            }
            if (strncmp(Command, "SET PERIMETER SPEED", 19) == 0) {
                int speed;
                char cmd1[3], cmd2[9], cmd3[5];
                sscanf(Command, "%s %s %s %d", cmd1, cmd2, cmd3, &speed);
                settings.perimeterTrackerSpeed = speed;
            }
            if (strncmp(Command, "SET PERIMETER CUT RATIO", 23) == 0) {
                int ratio;
                char cmd1[3], cmd2[9], cmd3[3], cmd4[5];
                sscanf(Command, "%s %s %s %s %d", cmd1, cmd2, cmd3, cmd4, &ratio);
                settings.cut_perimeter_ratio = ratio;
            }
            if (strncmp(Command, "SET ADC LEVEL", 13) == 0) {
                int adc;
                char cmd1[3], cmd2[3], cmd3[5];
                sscanf(Command, "%s %s %s %d", cmd1, cmd2, cmd3, &adc);
                settings.adcLevel = adc;
            }
            if (strncmp(Command, "SET CUTTER SPEED", 16) == 0) {
                int speed;
                char cmd1[3], cmd2[5], cmd3[3];
                sscanf(Command, "%s %s %s %d", cmd1, cmd2, cmd3, &speed);
                settings.cutterSpeed = speed;
            }
            if (strncmp(Command, "SET BOUNDARY TIMEOUT", 20) == 0) {
                int limit;
                char cmd1[3], cmd2[8], cmd3[7];
                sscanf(Command, "%s %s %s %d ", cmd1, cmd2, cmd3, &limit);
                settings.Boundary_Timeout = limit;
            }
            if (strncmp(Command, "SET OVERTURN LIMIT", 18) == 0) {
                int limit;
                char cmd1[3], cmd2[8], cmd3[5];
                sscanf(Command, "%s %s %s %d ", cmd1, cmd2, cmd3, &limit);
                settings.Overturn_Limit = limit;
            }
            if (strncmp(Command, "SET OUTSIDE LIMIT", 17) == 0) {
                int limit;
                char cmd1[3], cmd2[7], cmd3[5];
                sscanf(Command, "%s %s %s %d ", cmd1, cmd2, cmd3, &limit);
                settings.Outside_Threshold = limit;
            }
            if (strncmp(Command, "SET BAT HIGH", 12) == 0) {
                float limit;
                char cmd1[3], cmd2[3], cmd3[4];
                sscanf(Command, "%s %s %s %f ", cmd1, cmd2, cmd3, &limit);
                settings.Battery_High_Limit = limit;
            }
            if (strncmp(Command, "SET BAT LOW", 11) == 0) {
                float limit;
                char cmd1[3], cmd2[3], cmd3[3];
                sscanf(Command, "%s %s %s %f ", cmd1, cmd2, cmd3, &limit);
                settings.Battery_Low_Limit = limit;
            }
            if (strncmp(Command, "SET BAT CHARGER TIME", 20) == 0) {
                int minutes;
                char cmd1[3], cmd2[3], cmd3[7], cmd4[4];
                sscanf(Command, "%s %s %s %s %d ", cmd1, cmd2, cmd3, cmd4, &minutes);
                settings.BatteryChargeTime = minutes;
            }
            if (strncmp(Command, "SET BWF OUT", 11) == 0) {
                float limit;
                char cmd1[3], cmd2[3], cmd3[3];
                sscanf(Command, "%s %s %s %f ", cmd1, cmd2, cmd3, &limit);
                settings.Signal_Integrity_OUT = limit;
            }
            if (strncmp(Command, "SET BWF IN", 10) == 0) {
                float limit;
                char cmd1[3], cmd2[3], cmd3[2];
                sscanf(Command, "%s %s %s %f ", cmd1, cmd2, cmd3, &limit);
                settings.Signal_Integrity_IN = limit;
            }
            if (strncmp(Command, "SET CHARGE DETECTION", 20) == 0) {
                int limit;
                char cmd1[3], cmd2[6], cmd3[9];
                sscanf(Command, "%s %s %s %d", cmd1, cmd2, cmd3, &limit);
                settings.HoldChargeDetection = limit;
            }
            if (strncmp(Command, "SET CUTTER LIMIT", 16) == 0) {
                float limit;
                char cmd1[3], cmd2[6], cmd3[5];
                sscanf(Command, "%s %s %s %f ", cmd1, cmd2, cmd3, &limit);
                settings.Cutter_Limit = limit;
            }
            if (strncmp(Command, "SET MOTOR LIMIT", 15) == 0) {
                float limit;
                char cmd1[3], cmd2[5], cmd3[5];
                sscanf(Command, "%s %s %s %f ", cmd1, cmd2, cmd3, &limit);
                settings.Motor_Limit = limit;
            }
            if (strncmp(Command, "SET MOVEMENT LIMIT", 18) == 0) {
                float limit;
                char cmd1[3], cmd2[8], cmd3[5];
                sscanf(Command, "%s %s %s %f ", cmd1, cmd2, cmd3, &limit);
                settings.movement = limit;
            }
            if (strncmp(Command, "SET MOVEMENT COUNT LIMIT", 24) == 0) {
                int limit;
                char cmd1[3], cmd2[8], cmd3[5], cmd4[5];
                sscanf(Command, "%s %s %s %s %d ", cmd1, cmd2, cmd3, cmd4, &limit);
                settings.move_count_limit = limit;
            }
            if (strncmp(Command, "SET BUMPER COUNT LIMIT", 22) == 0) {
                int limit;
                char cmd1[3], cmd2[6], cmd3[5], cmd4[5];
                sscanf(Command, "%s %s %s %s %d ", cmd1, cmd2, cmd3, cmd4, &limit);
                settings.bumper_count_limit = limit;
            }
            if (strncmp(Command, "SET UNDOCK BACKING SECONDS", 26) == 0) {
                int seconds;
                char cmd1[3], cmd2[6], cmd3[5], cmd4[5];
                sscanf(Command, "%s %s %s %s %d ", cmd1, cmd2, cmd3, cmd4, &seconds);
                settings.undock_backing_seconds = seconds;
            }
            if (strncmp(Command, "SET DATE", 8) == 0) {
                int year = 0, month = 0, day = 0, weekday = 0;
                char cmd1[3], cmd2[4];
                sscanf(Command, "%s %s %d %d %d %d", cmd1, cmd2, &year, &month, &day, &weekday);
                setDate(year, month, day, weekday);
            }
            if (strncmp(Command, "SET TIME", 8) == 0) {
                int hour = 0, minute = 0, second = 0;
                char cmd1[3], cmd2[4];
                sscanf(Command, "%s %s %d %d %d", cmd1, cmd2, &hour, &minute, &second);
                setTime(hour, minute, second);
            }
            if (strncmp(Command, "SET KP", 6) == 0) {
                float pid_kp;
                char cmd1[3], cmd2[2];
                sscanf(Command, "%s %s %f", cmd1, cmd2, &pid_kp);
                settings.kp = pid_kp;
            }
            if (strncmp(Command, "SET KI", 6) == 0) {
                float pid_ki;
                char cmd1[3], cmd2[2];
                sscanf(Command, "%s %s %f", cmd1, cmd2, &pid_ki);
                settings.ki = pid_ki;
            }
            if (strncmp(Command, "SET KD", 6) == 0) {
                float pid_kd;
                char cmd1[3], cmd2[2];
                sscanf(Command, "%s %s %f", cmd1, cmd2, &pid_kd);
                settings.kd = pid_kd;
            }
            if (strncmp(Command, "SET WORKING START", 17) == 0) {
                int start;
                char cmd1[3], cmd2[7], cmd3[5];
                sscanf(Command, "%s %s %s %d", cmd1, cmd2, cmd3, &start);
                settings.WorkingHourStart = start;
            }
            if (strncmp(Command, "SET WORKING END", 15) == 0) {
                int end;
                char cmd1[3], cmd2[7], cmd3[3];
                sscanf(Command, "%s %s %s %d", cmd1, cmd2, cmd3, &end);
                settings.WorkingHourEnd = end;
            }
            if (strncmp(Command, "SET MAG VALUE", 13) == 0) {
                int magValue;
                char cmd1[3], cmd2[3], cmd3[5];
                sscanf(Command, "%s %s %s %d", cmd1, cmd2, cmd3, &magValue);
                settings.magValue = magValue;
            }
            if (strncmp(Command, "SET MAGMIN VALUE", 16) == 0) {
                int magMinValue;
                char cmd1[3], cmd2[6], cmd3[5];
                sscanf(Command, "%s %s %s %d", cmd1, cmd2, cmd3, &magMinValue);
                settings.magMinValue = magMinValue;
            }
            if (strncmp(Command, "SET HIGHGRASS LIMIT", 19) == 0) {
                float highgrass;
                char cmd1[3], cmd2[9], cmd3[5];
                sscanf(Command, "%s %s %s %f", cmd1, cmd2, cmd3, &highgrass);
                settings.highgrass_Limit = highgrass;
            }
            if (strcmp(Command, "DISABLE") == 0) {
                MasterSwitch = 0;
                add_error_event("User typed disable");
                Serial_Console("RazorBoard DISABLED.\r\n");
                Serial_Console("Please type <help> to see available commands\r\n");
            }

            if (strcmp(Command, "ENABLE") == 0) {
                MasterSwitch = 1;
                add_error_event("User typed enable");
                Serial_Console("RazorBoard ENABLED. STEP AWAY FROM THE VEHICLE!\r\n");
                Initial_Start = 0;
            }
            if (strcmp(Command, "TRACK PERIMETER") == 0) {
                perimeterTracking = 1;
                Serial_Console("Perimeter tracking ENABLED\r\n");
            }
            if (strcmp(Command, "RESETI2C") == 0) {
                reInitIMU();
            }

            if (strcmp(Command, "HELP") == 0) {
                help();
            }

            memset(ConsoleBuffer, 0, sizeof(CONSOLE_BFR_SIZE));

            UART1_ready = 0;
            break;
        }
    }
    UART1_ready = 0;
}

void parseCommand_RPI() {
    // Parse commands from the Raspberry PI

    char Command[64] = {"\0"};

    for (uint8_t x = 0; x < sizeof(PIBuffer); x++) {
        if (PIBuffer[x] == 13) {
            memcpy(Command, PIBuffer, x);
            sprintf(msg, "%s\r\n", Command);
            if (strcmp(Command, "RUN") == 0) {
                MasterSwitch = 1;
                Serial_RPi("Status: RUN\r\n");
                Serial_Console("Status: RUN\r\n");
            }
            if (strcmp(Command, "GOHOME") == 0) {
                perimeterTracking = 1;
            }
            if (strcmp(Command, "STOP") == 0) {
                MasterSwitch = 0;

                Serial_RPi("Status: STOP\r\n");
                Serial_Console("Status: STOP\r\n");
            }
            Serial_Console(msg);
            UART2_ready = 0;

            break;
        }
    }
}

void Serial_Console(char *msg) {
    // Write to USB/Serial

    HAL_UART_Transmit(&huart1, (uint8_t *) msg, strlen(msg), 100);
}

void Serial_RPi(char *msg) {
    // Write to Raspberry PI

    HAL_UART_Transmit(&huart2, (uint8_t *) msg, strlen(msg), 100);
}

uint8_t CheckSecurity(void) {
    // Check security, what is our status with the boundary signals

    CheckBWF();

    if (State == BACKWARD) {
        CheckBWF_Rear();
        if (BWF3_Status == OUTSIDE) {
            return SECURITY_BACKWARD_OUTSIDE;
        }
    }

    if (fabsf(mpu.pitch) >= settings.Overturn_Limit || fabsf(mpu.roll) >= settings.Overturn_Limit) {
        getIMUOrientation();    // Double check pitch and roll
        delay(100);
        if (fabsf(mpu.pitch) >= settings.Overturn_Limit || fabsf(mpu.roll) >= settings.Overturn_Limit) {
            sprintf(emsg, "Overturn: pitch %.1f roll %.1f", mpu.pitch, mpu.roll);
            add_error_event(emsg);
            MotorHardBrake();
            cutterHardBreak();
            return SECURITY_IMU_FAIL;
        }
    }

    if (HAL_GetTick() - Boundary_Timer >= (settings.Boundary_Timeout * 1000)) {
        BWF1_Status = NOSIGNAL;
        BWF2_Status = NOSIGNAL;
        State = FAIL;
        Security = NOSIGNAL;
        return SECURITY_NOSIGNAL;
    }

    if (Initial_Start == 0) {
        move_timer = HAL_GetTick();
    }

    if ((MOTOR_LEFT_FORWARD >= (settings.motorMaxSpeed * 0.5) || MOTOR_RIGHT_FORWARD >= (settings.motorMaxSpeed * 0.5)) && mpu.movement < settings.movement) {
        if (HAL_GetTick() - move_timer >= 5000) {
            move_count++;
            return SECURITY_MOVEMENT;
        }
    } else {
        move_timer = HAL_GetTick();
    }
    if (BWF1_Status == INSIDE || BWF2_Status == INSIDE) {
        OUTSIDE_timer = HAL_GetTick();        // We are inside with at least one sensor, reset OUTSIDE_timer
    }

    if (BWF1_Status == INSIDE && BWF2_Status == INSIDE) {
        Security = INSIDE;
        return SECURITY_OK;
    } else if (BWF1_Status == OUTSIDE || BWF2_Status == OUTSIDE) {
        Security = OUTSIDE;
        return SECURITY_FAIL;
    }

    return SECURITY_FAIL;
}

void cutterHardBreak() {
    // Cutter disc hard brake

    TIM3->CCR1 = 3359;        // Motor will hard brake when both "pins" go HIGH
    TIM3->CCR2 = 3359;
    HAL_Delay(3000);
    cutterOFF();
}

void cutterON(void) {
    cutterStatus = 1;
    uint8_t direction = 0;
    if (rnd(100000) < 50000) {
        direction = 1;
    }

    Serial_Console("Cutter Motor ON\r\n");
    add_error_event("Cutter Motor ON");

    for (uint16_t cutterSpeed = 1000; cutterSpeed < settings.cutterSpeed; cutterSpeed++) {
        Boundary_Timer = HAL_GetTick();

        if (direction == 0) {
            TIM3->CCR1 = cutterSpeed;
            TIM3->CCR2 = 0;
        } else {
            TIM3->CCR1 = 0;
            TIM3->CCR2 = cutterSpeed;
        }
        delay(2);
    }
}

void cutterOFF(void) {
    cutterStatus = 0;

    TIM3->CCR1 = 0;
    TIM3->CCR2 = 0;
}

void CheckBWF_Rear() {
    float BWF3_Mixed_Signal = 0;
    float BWF3_Received_Signal = 0;
    uint16_t myID = 0;
    uint8_t BWF3_reply = 0;
    float Match_Signal = 0;
    float Result_Signal = 0;
    float BWF3_Verdict_Signal = 0.0;
    int count = 0;

    for (int x = 0; x < ADC_SAMPLE_LEN; x++) {
        if (x % 2) {
            count++;
        } else {
            BWF3[count] = ADC_REAR_BUFFER[x] - settings.adcLevel;        // Normalize the ADC signal
        }
    }

    FIR_REAR();

    for (uint16_t idx = 0; idx < 96; idx++) {
        if (BWF3_reply == 1) {
            break;
        }
        myID = 0;
        BWF3_Mixed_Signal = 0;
        BWF3_Received_Signal = 0;
        Match_Signal = 0;


        for (int x = idx; x < (idx + SIGNATURE_LEN - 1); x++) {
            BWF3_Mixed_Signal += (BWF3[x] * validSignature[myID]);
            BWF3_Received_Signal += BWF3[x] * BWF3[x];

            Match_Signal += validSignature[myID] * validSignature[myID];
            myID++;
        }

        arm_sqrt_f32((BWF3_Received_Signal * Match_Signal), &Result_Signal);
        BWF3_Verdict_Signal = (BWF3_Mixed_Signal / Result_Signal);

        if (BWF3_Verdict_Signal >= settings.Signal_Integrity_IN && BWF3_reply == 0) {
            BWF3_Status = INSIDE;
            Boundary_Timer = HAL_GetTick();
            BWF3_reply = 1;
            bwf3_inside++;
        } else if (BWF3_Verdict_Signal <= settings.Signal_Integrity_OUT && BWF3_reply == 0) {
            BWF3_Status = OUTSIDE;
            Boundary_Timer = HAL_GetTick();
            BWF3_reply = 1;
            bwf3_outside++;
        }
    }
}

void CheckBWF() {
    /*
     * From the 512 samples, break out 256 for each sensor
     * Run FIR filter
     * Run Cross-Correlation to find a signal match.
     * 1.0 = 100% match for INSIDE
     * 0.85 = 85% match for INSIDE
     * -0.75 = 75% match for OUTSIDE
     * -1.0 = 100% match for OUTSIDE
     */

    float BWF1_Mixed_Signal = 0;
    float BWF1_Received_Signal = 0;
    float BWF2_Mixed_Signal = 0;
    float BWF2_Received_Signal = 0;
    uint16_t myID = 0;
    uint8_t BWF1_reply = 0;
    uint8_t BWF2_reply = 0;
    float Match_Signal = 0;
    float Result_Signal = 0;
    float BWF1_Verdict_Signal = 0.0;
    float BWF2_Verdict_Signal = 0.0;
    int count = 0;

    for (int x = 0; x < ADC_SAMPLE_LEN; x++) {
        if (x % 2) {
            BWF2[count] = ADC_BUFFER[x] - settings.adcLevel;        // Normalize the ADC signal
            count++;
        } else {
            BWF1[count] = ADC_BUFFER[x] - settings.adcLevel;        // Normalize the ADC signal
        }
    }

    FIR_LEFT();        // Run FIR on left BWF	(BWF1)
    FIR_RIGHT();    // Run FIR on right BWF	(BWF2)

    if (Signature_Record == TRUE) {
        for (uint16_t x = 0; x < SIGNATURE_LEN; x++) {
            validSignature[x] = BWF1[x];
        }
        Signature_Record = FALSE;
    }

    for (uint16_t idx = 0; idx < 96; idx++) {
        if (BWF1_reply == 1 && BWF2_reply == 1) {
            break;
        }
        myID = 0;
        BWF1_Mixed_Signal = 0;
        BWF1_Received_Signal = 0;
        BWF2_Mixed_Signal = 0;
        BWF2_Received_Signal = 0;
        Match_Signal = 0;


        for (int x = idx; x < (idx + SIGNATURE_LEN - 1); x++) {
            BWF1_Mixed_Signal += (BWF1[x] * validSignature[myID]);
            BWF1_Received_Signal += BWF1[x] * BWF1[x];

            BWF2_Mixed_Signal += (BWF2[x] * validSignature[myID]);
            BWF2_Received_Signal += BWF2[x] * BWF2[x];

            Match_Signal += validSignature[myID] * validSignature[myID];
            myID++;
        }

        arm_sqrt_f32((BWF1_Received_Signal * Match_Signal), &Result_Signal);
        BWF1_Verdict_Signal = (BWF1_Mixed_Signal / Result_Signal);

        arm_sqrt_f32((BWF2_Received_Signal * Match_Signal), &Result_Signal);
        BWF2_Verdict_Signal = (BWF2_Mixed_Signal / Result_Signal);

        if (BWF1_Verdict_Signal >= settings.Signal_Integrity_IN && BWF1_reply == 0) {
            BWF1_Status = INSIDE;
            Boundary_Timer = HAL_GetTick();
            BWF1_reply = 1;
            if (Initial_Start == 0) {
                Start_Threshold++;
                if (Start_Threshold >= INITIAL_MAX_THRESHOLD) {
                    Initial_Start = 1;
                }
            }
            bwf1_inside++;
            CalcMagnitude(1);
        } else if (BWF1_Verdict_Signal <= settings.Signal_Integrity_OUT && BWF1_reply == 0) {
            BWF1_Status = OUTSIDE;
            Boundary_Timer = HAL_GetTick();
            BWF1_reply = 1;
            if (Initial_Start == 0) {
                Start_Threshold = 0;
            }
            bwf1_outside++;
            CalcMagnitude(1);
        }

        if (BWF2_Verdict_Signal >= settings.Signal_Integrity_IN && BWF2_reply == 0) {
            BWF2_Status = INSIDE;
            Boundary_Timer = HAL_GetTick();
            BWF2_reply = 1;
            if (Initial_Start == 0) {
                Start_Threshold++;
                if (Start_Threshold >= INITIAL_MAX_THRESHOLD) {
                    Initial_Start = 1;
                }
            }
            bwf2_inside++;
            CalcMagnitude(2);
        } else if (BWF2_Verdict_Signal <= settings.Signal_Integrity_OUT && BWF2_reply == 0) {
            BWF2_Status = OUTSIDE;
            Boundary_Timer = HAL_GetTick();
            BWF2_reply = 1;
            if (Initial_Start == 0) {
                Start_Threshold = 0;
            }
            bwf2_outside++;
            CalcMagnitude(2);
        }
    }
}

void ADC_Send(uint8_t Channel) {
	// Send ADC data

	unsigned char ADSwrite[3];

	ADSwrite[0] = 0x01;
	ADSwrite[1] = Channel;
	ADSwrite[2] = 0x83;
	if (HAL_I2C_Master_Transmit(&hi2c1, ADS1115_ADDRESS << 1, ADSwrite, 3, 100) != HAL_OK) {
		I2C_ClearBusyFlagErratum(&hi2c1, 100);
		return;
	}
	ADSwrite[0] = 0x00;
	if (HAL_I2C_Master_Transmit(&hi2c1, ADS1115_ADDRESS << 1, ADSwrite, 1, 100) != HAL_OK) {
		I2C_ClearBusyFlagErratum(&hi2c1, 100);
		return;
	}
}

int ADC_Receive() {
	// Receive ADC data

	unsigned char ADSwrite[2];
	int reading;

	if (HAL_I2C_Master_Receive(&hi2c1, ADS1115_ADDRESS << 1, ADSwrite, 2, 100) != HAL_OK) {
		I2C_ClearBusyFlagErratum(&hi2c1, 100);
		return 0;

	}

	reading = (ADSwrite[0] << 8 | ADSwrite[1]);

	if (reading < 0 || reading > 32767) {
		reading = 0;
	}

	return reading;
}

void UpdateMotorSpeed() {
    /* With the use of the MPU6050, we calculate the angle we are traveling in by using the gyro
     * A simple motor speed controller, for each degree off, we simply decrease the speed with 120.
     * TODO - a proper PID controller
     */

    int16_t diff;
    int8_t dir = 0;

    // Calculate the difference in bearing, 0-360 accounted for. (Circular heading)
    diff = (((((int) mpu.heading - (int) mpu.hold_heading) % 360) + 540) % 360) - 180;
    diff *= settings.steering_correction;

    if (diff < 0) {
        dir = -1;
    } else if (diff > 0) {
        dir = 1;
    } else if (diff == 0) {
        dir = 0;
    }

    // Do not change speed more than 1000
    if (diff > 1000) {
        diff = 1000;
    }
    if (diff < -1000) {
        diff = -1000;
    }

    uint16_t Speed;
    if (mag_near_bwf == 1 || highgrass_slowdown == 1) {
        Speed = settings.motorMaxSpeed;
        if (mag_near_bwf == 1) {
            Speed = round(Speed * settings.proximitySpeed);
        } else if (highgrass_slowdown == 1) {
            Speed = round(Speed * 0.78);
        }
    } else {
        Speed = settings.motorMaxSpeed;
    }

    // Target is on the Left side
    if (dir > 0) {
        int CorrectedSpeed = Speed - abs(diff);
        MOTOR_LEFT_FORWARD = CorrectedSpeed;
        MOTOR_RIGHT_FORWARD = Speed;
    }
        // Target is on the Right side
    else if (dir < 0) {
        int CorrectedSpeed = Speed - abs(diff);
        MOTOR_LEFT_FORWARD = Speed;
        MOTOR_RIGHT_FORWARD = CorrectedSpeed;
    }
        // Spot on! Full speed ahead Captain!
    else if (dir == 0) {
        MOTOR_LEFT_FORWARD = Speed;
        MOTOR_RIGHT_FORWARD = Speed;
    }
}

void MotorForward(uint16_t minSpeed, uint16_t maxSpeed) {
	if (Docked == 1) return;
    State = FORWARD;

    getIMUOrientation();

    move_timer = HAL_GetTick();

    for (uint16_t currentSpeed = minSpeed; currentSpeed < maxSpeed; currentSpeed++) {
        currentSpeed += 3;
        if (currentSpeed >= maxSpeed) {
            break;
        }

        uint16_t leftTilt = 0;
        uint16_t rightTilt = 0;

        if (mpu.roll < 0) {
            leftTilt = fabsf(mpu.roll * settings.roll_tilt_comp);
        }
        if (mpu.roll > 0) {
            rightTilt = fabsf(mpu.roll * settings.roll_tilt_comp);
        }

        MOTOR_LEFT_BACKWARD = 0;
        MOTOR_LEFT_FORWARD = currentSpeed - round(leftTilt);

        MOTOR_RIGHT_FORWARD = currentSpeed - round(rightTilt);
        MOTOR_RIGHT_BACKWARD = 0;

        HAL_Delay(1);

        if (CheckSecurity() == SECURITY_FAIL) {
            MotorStop();
            break;
        }
    }
}

void MotorBackward(uint16_t minSpeed, uint16_t maxSpeed, uint32_t time_ms) {
    MotorBackwardImpl(minSpeed, maxSpeed, time_ms, false);
}

void MotorBackwardImpl(uint16_t minSpeed, uint16_t maxSpeed, uint32_t time_ms, bool forced) {
    add_error_event("MotorBackward");
    uint32_t motor_timer;
    State = BACKWARD;
    motor_timer = HAL_GetTick();

    getIMUOrientation();

    for (uint16_t currentSpeed = minSpeed; currentSpeed < maxSpeed; currentSpeed++) {
        currentSpeed += 3;
        if (currentSpeed >= maxSpeed) {
            break;
        }

        uint16_t leftTilt = 0;
        uint16_t rightTilt = 0;

        if (mpu.roll < 0) {
            leftTilt = fabsf(mpu.roll * settings.roll_tilt_comp);
        }
        if (mpu.roll > 0) {
            rightTilt = fabsf(mpu.roll * settings.roll_tilt_comp);
        }

        MOTOR_LEFT_BACKWARD = currentSpeed - round(rightTilt);
        MOTOR_LEFT_FORWARD = 0;

        MOTOR_RIGHT_FORWARD = 0;
        MOTOR_RIGHT_BACKWARD = currentSpeed - round(leftTilt);

        HAL_Delay(1);

        if (!forced && CheckSecurity() == SECURITY_BACKWARD_OUTSIDE) {
            MotorHardBrake();
            delay(1000);
            MotorForward(settings.motorMinSpeed, settings.motorMaxSpeed);
            delay(500);
            MotorStop();
            delay(500);
            return;
        }

        if (HAL_GetTick() - motor_timer >= time_ms) {
            break;
        }
    }
    while (HAL_GetTick() - motor_timer < time_ms) {
        if (!forced && CheckSecurity() == SECURITY_BACKWARD_OUTSIDE) {
            MotorHardBrake();
            delay(1000);
            MotorForward(settings.motorMinSpeed, settings.motorMaxSpeed);
            delay(500);
            MotorStop();
            delay(500);
            return;
        }

        delay(100);
    }
    MotorStop();
}

void MotorRight(uint16_t minSpeed, uint16_t maxSpeed, uint32_t time_ms) {
	if (Docked == 1) return;
    add_error_event("MotorRight");
    State = RIGHT;
    uint32_t motor_timer;
    motor_timer = HAL_GetTick();

    for (uint16_t currentSpeed = minSpeed; currentSpeed < maxSpeed; currentSpeed++) {
        currentSpeed += 3;
        if (currentSpeed >= maxSpeed) {
            break;
        }
        MOTOR_LEFT_BACKWARD = 0;
        MOTOR_LEFT_FORWARD = currentSpeed;

        MOTOR_RIGHT_FORWARD = 0;
        MOTOR_RIGHT_BACKWARD = currentSpeed;

        HAL_Delay(1);

        CheckSecurity();

        if (HAL_GetTick() - motor_timer >= time_ms) {
            break;
        }
    }
    while (HAL_GetTick() - motor_timer < time_ms) {
        CheckSecurity();
    }
    MotorStop();
}

void MotorLeft(uint16_t minSpeed, uint16_t maxSpeed, uint32_t time_ms) {
	if (Docked == 1) return;
    add_error_event("MotorLeft");
    State = LEFT;
    uint32_t motor_timer;
    motor_timer = HAL_GetTick();

    for (uint16_t currentSpeed = minSpeed; currentSpeed < maxSpeed; currentSpeed++) {
        currentSpeed += 3;
        if (currentSpeed >= maxSpeed) {
            break;
        }
        MOTOR_LEFT_BACKWARD = currentSpeed;
        MOTOR_LEFT_FORWARD = 0;

        MOTOR_RIGHT_FORWARD = currentSpeed;
        MOTOR_RIGHT_BACKWARD = 0;

        HAL_Delay(1);

        CheckSecurity();

        if (HAL_GetTick() - motor_timer >= time_ms) {
            break;
        }
    }
    while (HAL_GetTick() - motor_timer < time_ms) {
        CheckSecurity();
    }
    MotorStop();
}

void MotorStop(void) {
    State = STOP;
    int speed = 0;

    speed = (MOTOR_LEFT_BACKWARD + MOTOR_LEFT_FORWARD + MOTOR_RIGHT_FORWARD + MOTOR_RIGHT_BACKWARD) / 2;
    speed *= 0.90;

    if (speed == 0) {
        return;
    }

    for (int x = speed; x > 1000; x--) {
        x -= 4;

        if (x < 1000) {
            break;
        }

        if (MOTOR_LEFT_BACKWARD != 0)
            MOTOR_LEFT_BACKWARD = x;
        if (MOTOR_LEFT_FORWARD != 0)
            MOTOR_LEFT_FORWARD = x;
        if (MOTOR_RIGHT_FORWARD != 0)
            MOTOR_RIGHT_FORWARD = x;
        if (MOTOR_RIGHT_BACKWARD != 0)
            MOTOR_RIGHT_BACKWARD = x;

        HAL_Delay(1);
    }

    MOTOR_LEFT_BACKWARD = 0;
    MOTOR_LEFT_FORWARD = 0;
    MOTOR_RIGHT_FORWARD = 0;
    MOTOR_RIGHT_BACKWARD = 0;
}

void MotorBrake(void) {
    State = BRAKE;

    // Brake - free wheeling
    MOTOR_LEFT_BACKWARD = 0;
    MOTOR_LEFT_FORWARD = 0;
    MOTOR_RIGHT_FORWARD = 0;
    MOTOR_RIGHT_BACKWARD = 0;
}

void MotorHardBrake(void) {
    State = HARDBRAKE;

    // Wheels will do a hard brake when both pins go HIGH.
    MOTOR_LEFT_BACKWARD = 3359;
    MOTOR_LEFT_FORWARD = 3359;
    MOTOR_RIGHT_FORWARD = 3359;
    MOTOR_RIGHT_BACKWARD = 3359;

    HAL_Delay(250);

    MotorBrake();    //Release motors

}

void CheckState(void) {
    /* This is our main loop function, this is where all the states are
     * What state is the mower in? and what to do next.
     */
    if (Initial_Start == 0) {
        return;
    }

    if (MasterSwitch == 0) {
        cutterOFF();
        MotorStop();
        return;
    }

    if (Security == NOSIGNAL) {
        MotorStop();
        cutterOFF();
        return;
    }

    if (HAL_GetTick() - OUTSIDE_timer >= (settings.Outside_Threshold * 1000) && Docked == 0) {
        Serial_Console("OUTSIDE timer triggered\r\n");
        MotorStop();
        cutterOFF();
        return;
    }
    if (bumper_count >= settings.bumper_count_limit) {
        add_error_event("Bumper detection HALT");
        MotorStop();
        MasterSwitch = 0;
        Serial_Console("Bumper detection - HALT\r\n");
        return;
    }

    if (CheckSecurity() == SECURITY_MOVEMENT) {
        add_error_event("Movement detection HALT");
        MotorStop();
        if (move_count >= settings.move_count_limit) {
            MasterSwitch = 0;
            Serial_Console("Movement detection - HALT\r\n");
            return;
        }
        delay(500);
        MotorBackward(settings.motorMinSpeed, settings.motorMaxSpeed, settings.motorBackward_time);
        MotorLeft(settings.motorMinSpeed, settings.motorMaxSpeed, settings.motorTurnStatic_time * 2);
        return;
    }
    if (State == FAIL) {
        add_error_event("State Fail, waiting");
        MotorStop();
        cutterOFF();
        while (CheckSecurity() != SECURITY_OK) {
        }
        State = STOP;
        return;
    } else if (State == FORWARD && CheckSecurity() == SECURITY_FAIL) {
        add_error_event("FORWARD+SECURITY_FAIL");
        MotorStop();
        getIMUOrientation();
        move_count = 0;
        bumper_count = 0;
        mag_near_bwf = 0;
        highgrass_slowdown = 0;
        TimeToGoHome();            // Check if within working hours, if not, go home
        if (perimeterTracking == 1) {
            if (rnd(100) > settings.cut_perimeter_ratio) {
                cutterOFF();
            }
            perimeterTrackingActive = 1;
            delay(500);
            GoHome_timer_IN = HAL_GetTick();
            GoHome_timer_OUT = HAL_GetTick();

            if (BWF1_Status == INSIDE && BWF2_Status == OUTSIDE) {
                return;
            }
            if (BWF1_Status == OUTSIDE && BWF2_Status == OUTSIDE) {
                return;
            }
            if (BWF1_Status == OUTSIDE && BWF2_Status == INSIDE) {
                while (BWF1_Status != INSIDE && BWF2_Status != OUTSIDE) {
                    MotorLeft(settings.motorMinSpeed, settings.motorMaxSpeed, settings.motorTurnStatic_time);
                    CheckSecurity();
                    if (HAL_GetTick() - GoHome_timer_IN >= 10000 || HAL_GetTick() - GoHome_timer_OUT >= 10000) {
                        perimeterTracking = 0;
                        perimeterTrackingActive = 0;
                        MasterSwitch = 0;
                        add_error_event("Stuck at turning on perimeter wire");
                        break;
                    }
                }
                GoHome_timer_IN = HAL_GetTick();
                GoHome_timer_OUT = HAL_GetTick();
                return;
            }

            return;
        }
        delay(500);

        CheckSecurity();                // Double check status of the sensors when we are standing still

        if (BWF1_Status == OUTSIDE && BWF2_Status == INSIDE) {
            add_error_event("BWF1 OUT BWF2 IN");
            MotorBackward(settings.motorMinSpeed, settings.motorMaxSpeed, (settings.motorBackward_time + (mpu.pitch * 50)));
            delay(500);
            MotorRight(settings.motorMinSpeed, settings.motorMaxSpeed, settings.motorTurnStatic_time + rnd(settings.motorTurnRandom_time));
        } else if (BWF1_Status == INSIDE && BWF2_Status == OUTSIDE) {
            add_error_event("BWF1 IN BWF2 OUT");
            MotorBackward(settings.motorMinSpeed, settings.motorMaxSpeed, (settings.motorBackward_time + (mpu.pitch * 50)));
            delay(500);
            MotorLeft(settings.motorMinSpeed, settings.motorMaxSpeed, settings.motorTurnStatic_time + rnd(settings.motorTurnRandom_time));
        } else if (BWF1_Status == OUTSIDE && BWF2_Status == OUTSIDE) {
            add_error_event("BWF1 OUT BWF2 OUT");
            MotorBackward(settings.motorMinSpeed, settings.motorMaxSpeed, (settings.motorBackward_time + (mpu.pitch * 50)));
            delay(500);
            if (rnd(100000) < 50000) {
                MotorLeft(settings.motorMinSpeed, settings.motorMaxSpeed, settings.motorTurnStatic_time + rnd(settings.motorTurnRandom_time));
            } else {
                MotorRight(settings.motorMinSpeed, settings.motorMaxSpeed, settings.motorTurnStatic_time + rnd(settings.motorTurnRandom_time));
            }
        }

        delay(500);
    } else if (State == FORWARD) {
        if (MOTOR_LEFT_FORWARD == 0 && MOTOR_RIGHT_FORWARD == 0) {
            State = STOP;
        }
    } else if (State == STOP && CheckSecurity() == SECURITY_OK) {
        delay(500);
        add_error_event("STOP+SECURITY_OK");
        mpu.hold_heading = mpu.heading;
        if (cutterStatus == 0 && perimeterTracking == 0) {
            cutterON();
        }
        mag_near_bwf = 0;
        highgrass_slowdown = 0;
        MotorForward(settings.motorMinSpeed, settings.motorMaxSpeed);
    } else if (State == STOP && CheckSecurity() == SECURITY_FAIL) {
        delay(500);
        add_error_event("STOP+SECURITY_FAIL");

        CheckSecurity();

        if (BWF1_Status == INSIDE && (BWF2_Status == OUTSIDE || BWF2_Status == NOSIGNAL)) {
            MotorLeft(settings.motorMinSpeed, settings.motorMaxSpeed, settings.motorTurnStatic_time + rnd(settings.motorTurnRandom_time));
        } else if (BWF2_Status == INSIDE && (BWF1_Status == OUTSIDE || BWF1_Status == NOSIGNAL)) {
            MotorRight(settings.motorMinSpeed, settings.motorMaxSpeed, settings.motorTurnStatic_time + rnd(settings.motorTurnRandom_time));
        } else if (BWF1_Status == OUTSIDE && BWF2_Status == OUTSIDE) {
            MotorBackward(settings.motorMinSpeed, settings.motorMaxSpeed, (settings.motorBackward_time + (mpu.pitch * 50)));
            MotorRight(settings.motorMinSpeed, settings.motorMaxSpeed, settings.motorTurnStatic_time + rnd(settings.motorTurnRandom_time));
        }
    }
}

/* USER CODE END 0 */

/**
  * @brief  The application entry point.
  * @retval int
  */
int main(void)
{
  /* MCU Configuration--------------------------------------------------------*/

  /* Reset of all peripherals, Initializes the Flash interface and the Systick. */
  HAL_Init();

  /* Configure the system clock */
  SystemClock_Config();

  /* Initialize all configured peripherals */
  MX_GPIO_Init();
  MX_DMA_Init();
  MX_ADC1_Init();
  MX_IWDG_Init();
  MX_RNG_Init();
  MX_USART1_UART_Init();
  MX_USART2_UART_Init();
  MX_TIM3_Init();
  MX_TIM4_Init();
  MX_RTC_Init();
  MX_TIM2_Init();
  MX_TIM5_Init();
  MX_I2C1_Init();
  MX_ADC2_Init();
  MX_I2C2_Init();
  /* USER CODE BEGIN 2 */

    i2c_scanner();

    HAL_TIM_Base_Start(&htim4);                    // Start TIM4 on wheel motors
    HAL_TIM_Base_Start(&htim3);                    // Start TIM3 on cutter motor

    HAL_TIM_PWM_Start(&htim4, TIM_CHANNEL_1);        //M1 Motor PWM
    HAL_TIM_PWM_Start(&htim4, TIM_CHANNEL_2);        //M1 Motor PWM
    HAL_TIM_PWM_Start(&htim4, TIM_CHANNEL_3);        //M2 Motor PWM
    HAL_TIM_PWM_Start(&htim4, TIM_CHANNEL_4);        //M2 Motor PWM
    HAL_TIM_PWM_Start(&htim3, TIM_CHANNEL_1);        //C1 Motor PWM
    HAL_TIM_PWM_Start(&htim3, TIM_CHANNEL_2);        //C1 Motor PWM

    HAL_TIM_Base_Start(&htim5);                    //Start Timer5 for MicroSeconds delay

    MOTOR_LEFT_BACKWARD = 0;                                //M1 Motor - Make sure PWM is 0
    MOTOR_LEFT_FORWARD = 0;                                //M1 Motor - Make sure PWM is 0
    MOTOR_RIGHT_FORWARD = 0;                                //M2 Motor - Make sure PWM is 0
    MOTOR_RIGHT_BACKWARD = 0;                                //M2 Motor - Make sure PWM is 0
    TIM3->CCR1 = 0;                                //C1 Motor - Make sure PWM is 0
    TIM3->CCR2 = 0;                                //C1 Motor - Make sure PWM is 0

  /* USER CODE END 2 */

  /* Infinite loop */
  /* USER CODE BEGIN WHILE */

    enable_backup_sram();

    WatchdogInit();                                // STM32 Watchdog - NEVER DISABLE THIS (for safety!)
    HAL_TIM_Base_Start_IT(&htim2);                // 1 second interrupt, will update the watchdog and send info to Serial Console

    Serial_RPi("RazorBoard booting...please wait!\r\n");
    Serial_Console("RazorBoard booting...please wait!\r\n");

    HAL_ADC_Start_DMA(&hadc1, (uint32_t *) ADC_BUFFER, ADC_SAMPLE_LEN);        // Start the DMA for continues scan mode
    HAL_ADC_Start_DMA(&hadc2, (uint32_t *) ADC_REAR_BUFFER, ADC_SAMPLE_LEN);

    InitFIR();                                    // Initiate the FIR functions in hardware

    HAL_RNG_Init(&hrng);                            // Initiate the True Random Number generator

    __HAL_UART_ENABLE_IT(&huart1, UART_IT_IDLE);    // Enable interrupt for Serial Console
    __HAL_UART_ENABLE_IT(&huart2, UART_IT_IDLE);    // Enable interrupt for the Raspberry Pi

    ADC_timer = HAL_GetTick();                    // Initial load of the ADC timer
    IMU_timer = HAL_GetTick();                    // Initial load of the IMU timer
    MotorSpeedUpdateFreq_timer = HAL_GetTick();    // Initial load of the MotorSpeedUpdateFreq

    HAL_Delay(5000);

    Init6050();                                    // Start the MPU-6050

    Boundary_Timer = HAL_GetTick();                // Initiate timer for the Boundary Wire

    delay_us(100);


    if (validate_settings(board_revision) == CONFIG_NOT_FOUND) {
        add_error_event("No config found");
        Serial_Console("No config found - Saving factory defaults\r\n");
        Serial_Console("Masterswitch set to OFF - please configure and save settings, then reboot\r\n");
        MasterSwitch = 0;
    }

    settings = read_all_settings();
    Serial_Console("Config loaded from SRAM\r\n");

    for (uint8_t x = 0; x < 60; x++) {
        V1_array[x] = settings.Battery_High_Limit;
    }

    Serial_RPi("Booting done!\r\n");
    Serial_Console("Booting done!\r\n");
    add_error_event("RazorBoard booted");

    while (1) {
        // Collect IMU data every 20 ms, non-blocking.
        if (HAL_GetTick() - IMU_timer >= 20) {
            MPU6050_Read_Accel();
            MPU6050_Read_Gyro();
            ProcessIMUData(settings);
            IMU_timer = HAL_GetTick();
        }

        if (perimeterTrackingActive == 0) {
            CheckSecurity();
            CheckState();

            if (State == FORWARD && Force_Active == 1) {
                if (HAL_GetTick() - MotorSpeedUpdateFreq_timer >= MotorSpeedUpdateFreq) {
                    UpdateMotorSpeed();
                    MotorSpeedUpdateFreq_timer = HAL_GetTick();
                }
            }
            CollectADC();
        } else {
            perimeterTracker();
        }

        ChargerConnected();

        if (Docked == 1) {
            cutterOFF();
            unDock();
        }

        HAL_UART_Receive_DMA(&huart1, ConsoleBuffer, CONSOLE_BFR_SIZE);
        HAL_UART_Receive_DMA(&huart2, PIBuffer, PI_BFR_SIZE);

        if (UART1_ready == 1) {
            parseCommand_Console();
        }
        if (UART2_ready == 1) {
            parseCommand_RPI();
        }
    }

    /* USER CODE END WHILE */

    /* USER CODE BEGIN 3 */
}
  /* USER CODE END 3 */


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
/* USER CODE BEGIN 4 */

void HAL_GPIO_EXTI_Callback(uint16_t GPIO_Pin) {
    if (HAL_GPIO_ReadPin(GPIOA, GPIO_PIN_8) == GPIO_PIN_RESET) {
        HAL_GPIO_WritePin(GPIOC, GPIO_PIN_10, GPIO_PIN_RESET);
        HAL_GPIO_WritePin(GPIOD, GPIO_PIN_0, GPIO_PIN_RESET);
    }
}

void HAL_TIM_PeriodElapsedCallback(TIM_HandleTypeDef *htim) {
    WatchdogRefresh();        // STM32 Watchdog - NEVER DISABLE THIS (for safety!)
    SendInfo();
}

void HAL_ADC_ConvCpltCallback(ADC_HandleTypeDef *hadc) {
}

void HAL_UART_TxCpltCallback(UART_HandleTypeDef *huart) {
}

void HAL_UART_RxCpltCallback(UART_HandleTypeDef *huart) {
    // UART Tx Complete Callback;


    if (huart == &huart1) {
        if (__HAL_UART_GET_FLAG(huart, UART_FLAG_IDLE)) {                    // Check if it is an "Idle Interrupt"
            __HAL_UART_CLEAR_IDLEFLAG(&huart1);                                // clear the interrupt
            HAL_UART_DMAStop(&huart1);
            UART1_ready = 1;                                                // Serial Console data is now ready to be processed

        }
    }
    if (huart == &huart2) {
        if (__HAL_UART_GET_FLAG(huart, UART_FLAG_IDLE)) {                    // Check if it is an "Idle Interrupt"
            __HAL_UART_CLEAR_IDLEFLAG(&huart2);                                // clear the interrupt
            HAL_UART_DMAStop(&huart2);
            UART2_ready = 1;                                                // // Raspberry Pi data is now ready to be processed

        }
    }
}

/* USER CODE END 4 */
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
