Selective031/RazorBoard/RazorBoard/RazorBoard.ioc

Mcu.UserName=STM32F415VGTx
PA10.Signal=USART1_RX
PA13.Signal=SYS_JTMS-SWDIO
PA14.Signal=SYS_JTCK-SWCLK
PA2.Signal=USART2_TX
PA3.Signal=USART2_RX
PA8.Signal=GPIO_Input
PA9.Signal=USART1_TX
PB10.Signal=I2C2_SCL
PB11.Signal=I2C2_SDA
PB3.Signal=SYS_JTDO-SWO
PB6.Signal=I2C1_SCL
PB7.Signal=I2C1_SDA
PC0.Signal=ADCx_IN10
PC1.Signal=ADCx_IN11
PC10.Signal=GPIO_Output
PC14-OSC32_IN.Signal=RCC_OSC32_IN
PC15-OSC32_OUT.Signal=RCC_OSC32_OUT
PC2.Signal=ADCx_IN12
PC3.Signal=ADCx_IN13
PC6.Signal=S_TIM3_CH1
PC7.Signal=S_TIM3_CH2
PD0.Signal=GPIO_Output
PD12.Signal=S_TIM4_CH1
PD13.Signal=S_TIM4_CH2
PD14.Signal=S_TIM4_CH3
PD15.Signal=S_TIM4_CH4
PH0-OSC_IN.Signal=RCC_OSC_IN
PH1-OSC_OUT.Signal=RCC_OSC_OUT
