Selective031/RazorBoard/RazorBoard/Core/Src/sram.c

/*
 * sram.c
 *
 *  Created on: 13 Apr 2021
 *      Author: Carl Wallmark
 */

#include "main.h"
#include "sram.h"
#include "string.h"
#include "stdio.h"
#include <stdlib.h>

extern RTC_HandleTypeDef hrtc;
sram_settings get_default_settings(uint8_t revision);

uint8_t read_sram_errorlog(uint16_t addr) {
    uint8_t i_retval;

    /* Enable clock to BKPSRAM */
    __HAL_RCC_BKPSRAM_CLK_ENABLE();
    /* Pointer write from specific location of backup SRAM */
    i_retval = *(uint16_t *) (BKPSRAM_BASE + addr);
    /* Disable clock to BKPSRAM */
    __HAL_RCC_BKPSRAM_CLK_DISABLE();
    return i_retval;
}

void write_sram_errorlog(uint8_t l_data, uint16_t addr) {
    /* Enable clock to BKPSRAM */
    __HAL_RCC_BKPSRAM_CLK_ENABLE();
    /* Pointer write on specific location of backup SRAM */
    *(uint16_t *) (BKPSRAM_BASE + addr) = l_data;
    /* Disable clock to BKPSRAM */
    __HAL_RCC_BKPSRAM_CLK_DISABLE();
}


uint8_t read_sram_uint8(uint8_t addr) {
    uint8_t i_retval;

    /* Enable clock to BKPSRAM */
    __HAL_RCC_BKPSRAM_CLK_ENABLE();
    /* Pointer write from specific location of backup SRAM */
    i_retval = *(uint8_t *) (BKPSRAM_BASE + addr);
    /* Disable clock to BKPSRAM */
    __HAL_RCC_BKPSRAM_CLK_DISABLE();
    return i_retval;
}

void write_sram_uint8(uint8_t l_data, uint8_t addr) {
    /* Enable clock to BKPSRAM */
    __HAL_RCC_BKPSRAM_CLK_ENABLE();
    /* Pointer write on specific location of backup SRAM */
    *(uint8_t *) (BKPSRAM_BASE + addr) = l_data;
    /* Disable clock to BKPSRAM */
    __HAL_RCC_BKPSRAM_CLK_DISABLE();
}

uint16_t read_sram_uint16(uint8_t addr) {
    uint16_t i_retval;

    /* Enable clock to BKPSRAM */
    __HAL_RCC_BKPSRAM_CLK_ENABLE();
    /* Pointer write from specific location of backup SRAM */
    i_retval = *(uint16_t *) (BKPSRAM_BASE + addr);
    /* Disable clock to BKPSRAM */
    __HAL_RCC_BKPSRAM_CLK_DISABLE();
    return i_retval;
}

void write_sram_uint16(uint16_t l_data, uint8_t addr) {
    /* Enable clock to BKPSRAM */
    __HAL_RCC_BKPSRAM_CLK_ENABLE();
    /* Pointer write on specific location of backup SRAM */
    *(uint16_t *) (BKPSRAM_BASE + addr) = l_data;
    /* Disable clock to BKPSRAM */
    __HAL_RCC_BKPSRAM_CLK_DISABLE();
}

uint32_t read_sram_uint32(uint8_t addr) {
    uint32_t i_retval;

    /* Enable clock to BKPSRAM */
    __HAL_RCC_BKPSRAM_CLK_ENABLE();
    /* Pointer write from specific location of backup SRAM */
    i_retval = *(uint32_t *) (BKPSRAM_BASE + addr);
    /* Disable clock to BKPSRAM */
    __HAL_RCC_BKPSRAM_CLK_DISABLE();
    return i_retval;
}

void write_sram_uint32(uint32_t l_data, uint8_t addr) {
    /* Enable clock to BKPSRAM */
    __HAL_RCC_BKPSRAM_CLK_ENABLE();
    /* Pointer write on specific location of backup SRAM */
    *(uint32_t *) (BKPSRAM_BASE + addr) = l_data;
    /* Disable clock to BKPSRAM */
    __HAL_RCC_BKPSRAM_CLK_DISABLE();
}

float read_sram_float(uint8_t addr) {
    uint32_t i_retval;

    /* Enable clock to BKPSRAM */
    __HAL_RCC_BKPSRAM_CLK_ENABLE();
    /* Pointer write from specific location of backup SRAM */
    i_retval = *(uint32_t *) (BKPSRAM_BASE + addr);
    /* Disable clock to BKPSRAM */
    __HAL_RCC_BKPSRAM_CLK_DISABLE();
    return *(float *) &i_retval;
}

void write_sram_float(float l_data, uint8_t addr) {
    /* Enable clock to BKPSRAM */
    __HAL_RCC_BKPSRAM_CLK_ENABLE();
    /* Pointer write on specific location of backup SRAM */
    *(uint32_t *) (BKPSRAM_BASE + addr) = *(uint32_t *) &l_data;
    /* Disable clock to BKPSRAM */
    __HAL_RCC_BKPSRAM_CLK_DISABLE();
}

void enable_backup_sram(void) {
    /*DBP : Enable access to Backup domain */
    HAL_PWR_EnableBkUpAccess();
    /*PWREN : Enable backup domain access  */
    __HAL_RCC_PWR_CLK_ENABLE();
    /*BRE : Enable backup regulator
      BRR : Wait for backup regulator to stabilize */
    HAL_PWREx_EnableBkUpReg();
    /*DBP : Disable access to Backup domain */
//    HAL_PWR_DisableBkUpAccess();
}

void clear_errors(void) {

    sram_error errors;
    errors = read_error_log();

    for (int x = 0; x < 20; x++) {
        sprintf(errors.elog[x], " ");
    }
    errors.index = 0;

    write_error_log(errors);


}

void scroll_error_list(void) {

    sram_error errors;
    errors = read_error_log();

    for (int x = 0; x < 19; x++) {
        strcpy(errors.elog[x], errors.elog[x + 1]);
    }

    write_error_log(errors);

}

void add_error_event(char *errormsg) {

    sram_error errors;
    errors = read_error_log();

    if (errors.index < 0 || errors.index > 20) errors.index = 0;

    if (errors.index == 20) {

        scroll_error_list();
        errors = read_error_log();
        errors.index = 19;

    }

    RTC_TimeTypeDef currTime = {0};
    RTC_DateTypeDef currDate = {0};

    HAL_RTC_GetTime(&hrtc, &currTime, RTC_FORMAT_BIN);
    HAL_RTC_GetDate(&hrtc, &currDate, RTC_FORMAT_BIN);

    sprintf(errors.elog[errors.index], "<%d:%d:%d> %s", currTime.Hours, currTime.Minutes, currTime.Seconds, errormsg);

    errors.index++;

    write_error_log(errors);
}

sram_error read_error_log(void) {

    sram_error errors;

    uint16_t index = 0;
    for (int line = 0; line < 20; line++) {
        for (int ch = 0; ch < 50; ch++) {
            errors.elog[line][ch] = read_sram_errorlog(ERRORLOG_ADDR + (index + 1));
            index++;
        }
    }

    errors.index = read_sram_errorlog(ERRORLOG_INDEX_ADDR);

    return errors;

}

sram_settings read_all_settings(void) {
    sram_settings settings;

    settings.Config_Set = read_sram_uint8(CONFIG_SET_ADDR);
    settings.Go_Home_Direction = read_sram_uint8(GO_GOME_DIRECTION_ADDR);
    settings.Boundary_Timeout = read_sram_uint32(BOUNDARY_TIMEOUT_ADDR);
    settings.WorkingHourStart = read_sram_uint8(WORKINGHOURSTART_ADDR);
    settings.WorkingHourEnd = read_sram_uint32(WORKINGHOUREND_ADDR);
    settings.Overturn_Limit = read_sram_uint8(OVERTURN_LIMIT_ADDR);
    settings.MotorSpeedUpdateFreq = read_sram_uint8(MOTORSPEEDUPDATEFREQ_ADDR);
    settings.Outside_Threshold = read_sram_uint8(OUTSIDE_THRESHOLD_ADDR);
    settings.move_count_limit = read_sram_uint8(MOVE_COUNT_ADDR);
    settings.bumper_count_limit = read_sram_uint8(BUMPER_COUNT_ADDR);
    settings.undock_backing_seconds = read_sram_uint8(UNDOCK_BACKING_SECONDS_ADDR);
    settings.cut_perimeter_ratio = read_sram_uint8(CUT_PERIMETER_RATIO_ADDR);

    settings.HoldChargeDetection = read_sram_uint16(HOLDCHARGEDETECTION_ADDR);
    settings.magValue = read_sram_uint16(MAGVALUE_ADDR);
    settings.magMinValue = read_sram_uint16(MAGMINVALUE_ADDR);
    settings.motorMaxSpeed = read_sram_uint16(MOTORMAXSPEED_ADDR);
    settings.motorMinSpeed = read_sram_uint16(MOTORMINSPEED_ADDR);
	settings.perimeterTrackerSpeed = read_sram_uint16(PERIMETERTRACKERSPEED_ADDR);
    settings.cutterSpeed = read_sram_uint16(CUTTERSPEED_ADDR);
    settings.adcLevel = read_sram_uint16(ADC_LEVEL_ADDR);
    settings.roll_tilt_comp = read_sram_uint16(ROLL_TILT_COMP_ADDR);
    settings.steering_correction = read_sram_uint16(STEERING_CORRECTION_ADDR);
    settings.motorTurnStatic_time = read_sram_uint16(MOTOR_TURN_STATIC_TIME_ADDR);
    settings.motorTurnRandom_time = read_sram_uint16(MOTOR_TURN_RANDOM_TIME_ADDR);
    settings.motorBackward_time = read_sram_uint16(MOTOR_BACKWARD_TIME_ADDR);

    settings.Battery_High_Limit = read_sram_float(BATTERY_HIGH_LIMIT_ADDR);
    settings.Battery_Low_Limit = read_sram_float(BATTERY_LOW_LIMIT_ADDR);
	settings.BatteryChargeTime =  read_sram_uint16(BATTERYCHARGETIME_ADDR);

    settings.Signal_Integrity_IN = read_sram_float(SIGNAL_INTEGRITY_IN_ADDR);
    settings.Signal_Integrity_OUT = read_sram_float(SIGNAL_INTEGRITY_OUT_ADDR);

    settings.Motor_Limit = read_sram_float(MOTOR_LIMIT_ADDR);
    settings.Cutter_Limit = read_sram_float(CUTTER_LIMIT_ADDR);

    settings.kp = read_sram_float(KP_ADDR);
    settings.ki = read_sram_float(KI_ADDR);
    settings.kd = read_sram_float(KD_ADDR);

    settings.Motor_Max_Limit = read_sram_float(Motor_Max_Limit_ADDR);
    settings.Motor_Min_Limit = read_sram_float(Motor_Min_Limit_ADDR);
    settings.voltageMultiply = read_sram_float(voltageMultiply_ADDR);
    settings.proximitySpeed = read_sram_float(proximitySpeed_ADDR);
    settings.movement = read_sram_float(MOVEMENT_ADDR);
    settings.pitch_comp = read_sram_float(PITCH_COMP_ADDR);
    settings.roll_comp = read_sram_float(ROLL_COMP_ADDR);
    settings.highgrass_Limit = read_sram_float(HIGHGRASS_LIMIT_ADDR);

    return settings;
}

void write_error_log(sram_error errors) {

    uint16_t index = 0;
    for (int line = 0; line < 20; line++) {
        for (int ch = 0; ch < 50; ch++) {
            write_sram_errorlog(errors.elog[line][ch], (ERRORLOG_ADDR + (index + 1)));
            index++;
        }
    }
    write_sram_errorlog(errors.index, ERRORLOG_INDEX_ADDR);

}

void write_all_settings(sram_settings settings) {

    // uint8_t = 1 byte
    // uint16_t = 2 byte
    //uint32_t = 4 byte
    //float = 4 byte

    // uint8_t & int8_t
    settings.Config_Set = global_settings_version;
    write_sram_uint8(settings.Config_Set, CONFIG_SET_ADDR);
    write_sram_uint8(settings.Go_Home_Direction, GO_GOME_DIRECTION_ADDR);
    write_sram_uint8(settings.Boundary_Timeout, BOUNDARY_TIMEOUT_ADDR);
    write_sram_uint8(settings.WorkingHourStart, WORKINGHOURSTART_ADDR);
    write_sram_uint8(settings.WorkingHourEnd, WORKINGHOUREND_ADDR);
    write_sram_uint8(settings.Overturn_Limit, OVERTURN_LIMIT_ADDR);
    write_sram_uint8(settings.MotorSpeedUpdateFreq, MOTORSPEEDUPDATEFREQ_ADDR);
    write_sram_uint8(settings.Outside_Threshold, OUTSIDE_THRESHOLD_ADDR);
    write_sram_uint8(settings.move_count_limit, MOVE_COUNT_ADDR);
    write_sram_uint8(settings.bumper_count_limit, BUMPER_COUNT_ADDR);
    write_sram_uint8(settings.undock_backing_seconds, UNDOCK_BACKING_SECONDS_ADDR);
    write_sram_uint8(settings.cut_perimeter_ratio, CUT_PERIMETER_RATIO_ADDR);


    // uint16_t
    write_sram_uint16(settings.HoldChargeDetection, HOLDCHARGEDETECTION_ADDR);
    write_sram_uint16(settings.magValue, MAGVALUE_ADDR);
    write_sram_uint16(settings.magMinValue, MAGMINVALUE_ADDR);
    write_sram_uint16(settings.motorMaxSpeed, MOTORMAXSPEED_ADDR);
    write_sram_uint16(settings.motorMinSpeed, MOTORMINSPEED_ADDR);
    write_sram_uint16(settings.perimeterTrackerSpeed, PERIMETERTRACKERSPEED_ADDR);
    write_sram_uint16(settings.cutterSpeed, CUTTERSPEED_ADDR);
    write_sram_uint16(settings.adcLevel, ADC_LEVEL_ADDR);
    write_sram_uint16(settings.BatteryChargeTime, BATTERYCHARGETIME_ADDR);
    write_sram_uint16(settings.roll_tilt_comp, ROLL_TILT_COMP_ADDR);
    write_sram_uint16(settings.steering_correction, STEERING_CORRECTION_ADDR);
    write_sram_uint16(settings.motorTurnStatic_time, MOTOR_TURN_STATIC_TIME_ADDR);
    write_sram_uint16(settings.motorTurnRandom_time, MOTOR_TURN_RANDOM_TIME_ADDR);
    write_sram_uint16(settings.motorBackward_time, MOTOR_BACKWARD_TIME_ADDR);


    // uint32_t & float
    write_sram_float(settings.Battery_High_Limit, BATTERY_HIGH_LIMIT_ADDR);
    write_sram_float(settings.Battery_Low_Limit, BATTERY_LOW_LIMIT_ADDR);
    write_sram_float(settings.Signal_Integrity_IN, SIGNAL_INTEGRITY_IN_ADDR);
    write_sram_float(settings.Signal_Integrity_OUT, SIGNAL_INTEGRITY_OUT_ADDR);
    write_sram_float(settings.Motor_Limit, MOTOR_LIMIT_ADDR);
    write_sram_float(settings.Cutter_Limit, CUTTER_LIMIT_ADDR);
    write_sram_float(settings.kp, KP_ADDR);
    write_sram_float(settings.ki, KI_ADDR);
    write_sram_float(settings.kd, KD_ADDR);
    write_sram_float(settings.Motor_Max_Limit, Motor_Max_Limit_ADDR);
    write_sram_float(settings.Motor_Min_Limit, Motor_Min_Limit_ADDR);
    write_sram_float(settings.voltageMultiply, voltageMultiply_ADDR);
    write_sram_float(settings.proximitySpeed, proximitySpeed_ADDR);
    write_sram_float(settings.movement, MOVEMENT_ADDR);
    write_sram_float(settings.pitch_comp, PITCH_COMP_ADDR);
    write_sram_float(settings.roll_comp, ROLL_COMP_ADDR);
    write_sram_float(settings.highgrass_Limit, HIGHGRASS_LIMIT_ADDR);

}

void save_default_settings(uint8_t revision) {

    sram_settings defaultSettings = get_default_settings(revision);
    write_all_settings(defaultSettings);
}

sram_settings get_default_settings(uint8_t revision) {

    sram_settings settings;

    settings.Config_Set = global_settings_version;
    settings.Go_Home_Direction = 0;
    settings.Battery_Low_Limit = 22.00;
    settings.Battery_High_Limit = 25.00;
    settings.Boundary_Timeout = 6;
    settings.Cutter_Limit = 2.0;
    settings.HoldChargeDetection = 350;
    settings.MotorSpeedUpdateFreq = 100;
    settings.Outside_Threshold = 8;
    settings.Motor_Limit = 4.0;
    settings.Overturn_Limit = 35;
    settings.Signal_Integrity_IN = 0.80;
    settings.Signal_Integrity_OUT = -0.80;
    settings.WorkingHourStart = 10;
    settings.WorkingHourEnd = 20;
    settings.kp = 0.20;
    settings.ki = 0.0;
    settings.kd = 0.4;
    settings.Motor_Max_Limit = 0.3;
    settings.Motor_Min_Limit = 0.1;
    settings.magValue = 400;
    settings.magMinValue = 370;
    settings.voltageMultiply = 5.0;
    settings.proximitySpeed = 0.80;
    settings.movement = 0.5;
    settings.motorMaxSpeed = 3360 - 1;
    settings.motorMinSpeed = 2000;
    settings.cutterSpeed = 3000;
    settings.move_count_limit = 5;
    settings.bumper_count_limit = 10;
    settings.undock_backing_seconds = 3;
    settings.pitch_comp = 0.0;
    settings.roll_comp = 0.0;
    settings.roll_tilt_comp = 50;
    settings.steering_correction = 120;
    settings.motorTurnStatic_time = 700;
    settings.motorTurnRandom_time = 700;
    settings.motorBackward_time = 1500;
    settings.highgrass_Limit = 1.5;
    settings.BatteryChargeTime = 60;
    settings.perimeterTrackerSpeed = 3360 - 1;
    settings.cut_perimeter_ratio = 0;

    if (revision == 12) {
        settings.adcLevel = 2050;
    }
    else if (revision == 10) {
        settings.adcLevel = 1267;
    }

    return settings;
}

uint8_t validate_settings(uint8_t revision) {
    sram_settings settings = read_all_settings();
    sram_settings defaultSettings = get_default_settings(revision);

    // Validate new version settings
    if (settings.Config_Set < 42 || settings.Config_Set > global_settings_version) {
        write_all_settings(defaultSettings);
        return CONFIG_NOT_FOUND;
    }

    if (settings.Config_Set < 43) {
        settings.undock_backing_seconds = defaultSettings.undock_backing_seconds;
    }

    if (settings.Config_Set < 44) {
        settings.BatteryChargeTime = defaultSettings.BatteryChargeTime;
        settings.perimeterTrackerSpeed = defaultSettings.perimeterTrackerSpeed;
        settings.roll_tilt_comp = defaultSettings.roll_tilt_comp;
    }

    if (settings.Config_Set < 45) {
        settings.steering_correction = defaultSettings.steering_correction;
        settings.cut_perimeter_ratio = defaultSettings.cut_perimeter_ratio;
    }

    if (settings.Config_Set < 46) {
    	settings.motorTurnStatic_time = defaultSettings.motorTurnStatic_time;
    	settings.motorTurnRandom_time = defaultSettings.motorTurnRandom_time;
    	settings.motorBackward_time = defaultSettings.motorBackward_time;
    }

    // Validate allowed values
    if (settings.perimeterTrackerSpeed < 1 || settings.perimeterTrackerSpeed > 3359) {
        settings.perimeterTrackerSpeed = defaultSettings.perimeterTrackerSpeed;
    }
    if (settings.cut_perimeter_ratio < 0 || settings.cut_perimeter_ratio > 100) {
        settings.cut_perimeter_ratio = defaultSettings.cut_perimeter_ratio;
    }

    if (settings.cutterSpeed < 1 || settings.cutterSpeed > 3359) {
        settings.cutterSpeed = defaultSettings.cutterSpeed;
    }

    if (settings.motorMinSpeed < 1 || settings.motorMinSpeed > 3359) {
        settings.motorMinSpeed = defaultSettings.motorMinSpeed;
    }

    if (settings.motorMaxSpeed < 1 || settings.motorMaxSpeed > 3359) {
        settings.motorMaxSpeed = defaultSettings.motorMaxSpeed;
    }

    if (settings.steering_correction < 0 || settings.steering_correction > 3359) {
        settings.steering_correction = defaultSettings.steering_correction;
    }

    if (settings.roll_tilt_comp < 0 || settings.roll_tilt_comp > 1000) {
        settings.roll_tilt_comp = defaultSettings.roll_tilt_comp;
    }

    if (settings.BatteryChargeTime < 0 || settings.BatteryChargeTime > 4 * 60) {
        settings.BatteryChargeTime = defaultSettings.BatteryChargeTime;
    }

    if (settings.undock_backing_seconds < 1 || settings.undock_backing_seconds > 30) {
        settings.undock_backing_seconds = defaultSettings.undock_backing_seconds;
    }

    if (settings.Signal_Integrity_OUT < -1 || settings.Signal_Integrity_OUT > 1) {
        settings.Signal_Integrity_OUT = defaultSettings.Signal_Integrity_OUT;
    }

    if (settings.Signal_Integrity_IN < -1 || settings.Signal_Integrity_IN > 1) {
        settings.Signal_Integrity_IN = defaultSettings.Signal_Integrity_IN;
    }

    if (settings.Battery_High_Limit < 7 || settings.Battery_High_Limit > 32) {
        settings.Battery_High_Limit = defaultSettings.Battery_High_Limit;
    }

    if (settings.Battery_Low_Limit < 7 || settings.Battery_Low_Limit > 32) {
        settings.Battery_Low_Limit = defaultSettings.Battery_Low_Limit;
    }

    if (settings.voltageMultiply < 0 || settings.voltageMultiply > 7) {
        settings.voltageMultiply = defaultSettings.voltageMultiply;
    }

    if (settings.roll_comp < -90 || settings.roll_comp > 90) {
        settings.roll_comp = defaultSettings.roll_comp;
    }

    if (settings.pitch_comp < -90 || settings.pitch_comp > 90) {
        settings.pitch_comp = defaultSettings.pitch_comp;
    }

    if (settings.highgrass_Limit < 0.5 || settings.highgrass_Limit > 10) {
        settings.highgrass_Limit = defaultSettings.highgrass_Limit;
    }

    if (settings.kd < 0 || settings.kd > 5) {
        settings.kd = defaultSettings.kd;
    }

    if (settings.ki < 0 || settings.ki > 5) {
        settings.ki = defaultSettings.ki;
    }

    if (settings.kp < 0 || settings.kp > 5) {
        settings.kp = defaultSettings.kp;
    }

    if (settings.motorTurnStatic_time < 0 || settings.motorTurnStatic_time > 4000) {
    	settings.motorTurnStatic_time = defaultSettings.motorTurnStatic_time;
    }

    if (settings.motorTurnRandom_time < 0 || settings.motorTurnRandom_time > 4000) {
    	settings.motorTurnRandom_time = defaultSettings.motorTurnRandom_time;
    }
    if (settings.motorBackward_time < 0 || settings.motorBackward_time > 4000) {
    	settings.motorBackward_time = defaultSettings.motorBackward_time;
    }

    settings.Config_Set = global_settings_version;
    write_all_settings(settings);
    return CONFIG_FOUND;
}
