Selective031/RazorBoard/RazorBoard/Core/Inc/signature.h

/*
 * signature.h
 *
 *  Created on: Mar 25, 2021
 *      Author: Carl Wallmark
 */

#ifndef INC_BWF_H_
#define INC_BWF_H_

#define ADC_SAMPLE_LEN			512			// How many samples taken for ADC Stream
#define SIGNATURE_SAMPLE_LEN	256			// How many samples taken for Signature
#define SIGNATURE_LEN			128			// Length of the signature

int16_t ADCADC[ADC_SAMPLE_LEN];
int16_t ADCADC_REAR[ADC_SAMPLE_LEN];
int16_t ADC_BUFFER[ADC_SAMPLE_LEN];
int16_t ADC_REAR_BUFFER[ADC_SAMPLE_LEN];
float32_t validSignature[SIGNATURE_LEN] =

{ 		214.871185,482.408661,653.609131,736.649292,744.055664,699.717102,634.489746,559.587341,
		481.410034,402.946167,274.879150,1.859665,-456.666931,-984.747070,-1400.364014,-1609.898560,
		-1647.239990,-1580.859863,-1457.802612,-1306.777954,-1145.464966,-983.490051,-825.570007,-674.374756,
		-532.315796,-400.884979,-280.461151,-170.435318,-70.510658,19.447758,122.199738,323.726929,700.389709,
		1208.363037,1672.670898,1952.999146,2033.851562,1945.888550,1653.926025,1135.521729,493.994507,-78.084106,
		-456.845459,-648.360107,-674.045715,-489.999023,-78.370308,441.802979,879.352356,1123.917725,1195.381592,
		1160.521240,1067.949341,946.498779,813.452881,678.432617,547.189697,414.493988,207.338837,-165.935196,
		-702.734619,-1241.603760,-1616.620850,-1779.445068,-1772.155640,-1573.519043,-1142.961914,-539.824768,
		46.724350,460.356567,673.637939,751.147949,749.207092,704.644043,639.792725,565.540833,487.172699,408.613647,
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
		-172.310364,-126.459335,-50.070358,15.486775,43.064396,30.122160,12.779818,6.025205,
		19.109524,33.366543,40.599743,30.006609,16.274815,-2.135866,-21.879539,-46.000122,
		-62.978409,-82.966522,-112.832474,-146.524368,-159.097488,-142.984848,-109.492645
};
*/
#endif /* INC_BWF_H_ */
