Selective031/RazorBoard/RazorBoard/Core/Inc/help.h

/*
 * help.h
 *
 *  Created on: Mar 30, 2021
 *      Author: Carl Wallmark
 */

#include "sram.h"

#ifndef INC_HELP_H_
#define INC_HELP_H_

void help(void);
void show_config(sram_settings settings);
void show_error();

#endif /* INC_HELP_H_ */
