Selective031/RazorBoard/(commit log)

2021-04-12 Small bug fix, increased offset
    [main.c]
2021-06-30 Merge of board revisions
    * Renamed project to RazorBoard
    * Version 1.2
    * Version 1.2
    * Fix undock problem
    * Added .gitignore
    * gohome test
    * unDocked moved
    * changed timer
    * update error.index
    * Setting for backing time when undock + ignore security checks when undocking (#20)
    * Setting for backing time when undock + ignore security checks when undocking
    * multiple fixes/changes
    * increased time for perimeterTracker
    * new function getIMUOrientation + fix
    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
    [RazorBoard.ioc, help.c, help.h, main.c, mpu6050.c, mpu6050.h, sram.c]
2021-07-01 Battery Charge Time
    Introduce a timer for how long the mower shall charge even though the max battery level is reached.
2021-07-01 Console command for update Battery Charge Time
    Added input console command to update Battery Charge Time
2021-07-01 PerimeterTrackerSpeed
    Introduce parameter to set the speed of the mower when follow the perimeter wire while going home
2021-07-03 Use define for motor CCR
2021-07-03 Default defines fot motor TIM4
2021-07-04 i2c fixes + some small improvements
    [RazorBoard.ioc, main.c]
2021-07-04 Fixed messed up statement
    [main.c]
2021-07-05 Added two missing commands to help + some spell checking for "bumber -> bumper"
    [help.c, main.c, sram.c, sram.h]
2021-07-05 change charger delays
2021-07-05 Settings versioning and validation + Setting for cut perimeter ratio + Setting for steering correction
    [help.c, main.c, sram.c, sram.h]
2021-07-06 relay change
2021-07-08 more I2C fixes + MPU fixes
    [RazorBoard.ioc, main.c, mpu6050.c, sram.c, sram.h]
2021-07-29 motor settings + i2c fix
    [help.c, main.c, sram.c, sram.h]
2021-07-29 i2c reset
2021-07-29 pitch fix
2021-07-29 perimeter track fix
2021-07-29 added motor commands
2021-07-30 wrong motor times
2021-07-30 Disable motors when docked
2021-07-30 motors limits
